zakerl/Capstone_Project/README.md

# The EMAnator - Back End Developers 
<p align="center">
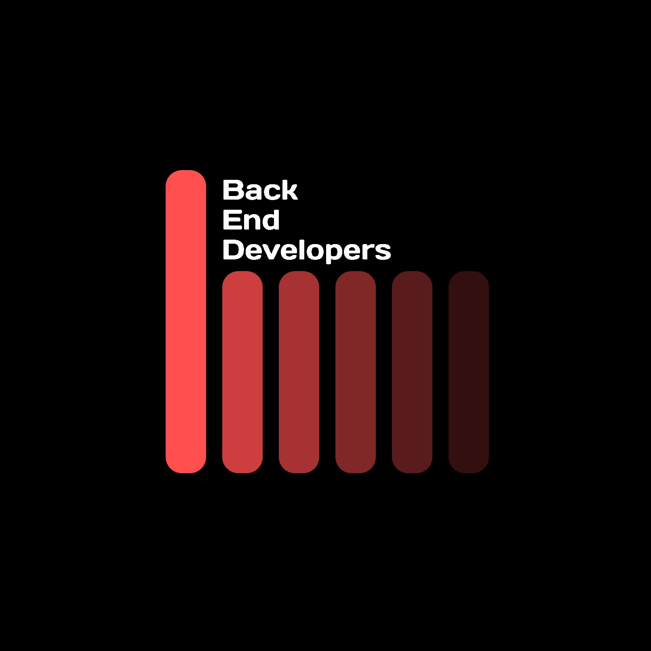
[picture p1: refs/BED_logo.jpg]
  
</p>

The EMAnator (Custom activity tracker) is a device created by the Back End Developers to assist Dr Luciana Macedo https://mira.mcmaster.ca/team/bio/luciana-macedo 
to perform Ecological Momentary Assessment (EMA) research on older adults with lumbar spinal stenosis.

To perform activity tracking, a prototype was engineered to replicate tracking using a sensor box as seen below:

 <p align="center">
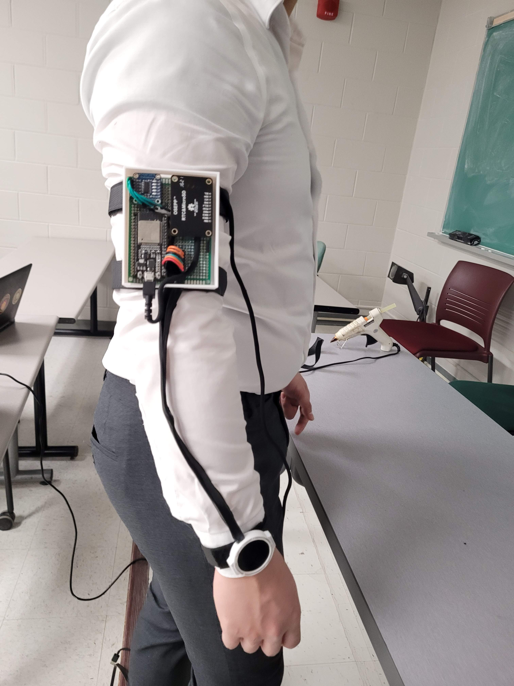
[picture p2: refs/sensorbox.jpg]
  
</p>

To make the device much smaller and like a smart watch that can be worn by participants, a PCB was designed from scratch as seen below:

 <p align="center">
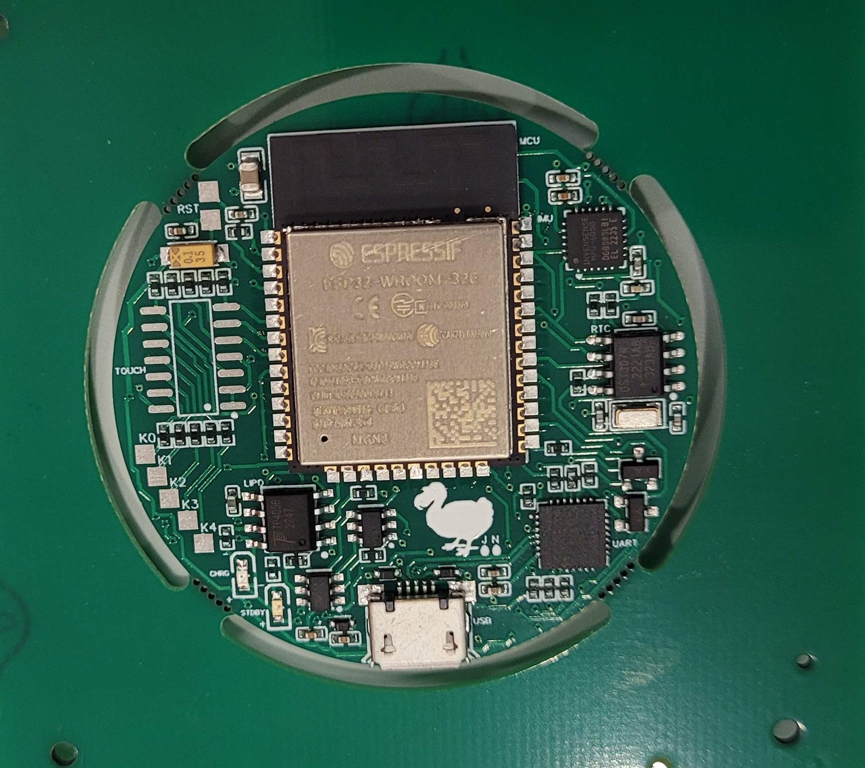
[picture p3: refs/PCB.jpg]
  
</p>

The final functional version of the product is shown below, it has a display and a touch sensor (metal strips) to navigate the display.

 <p align="center">
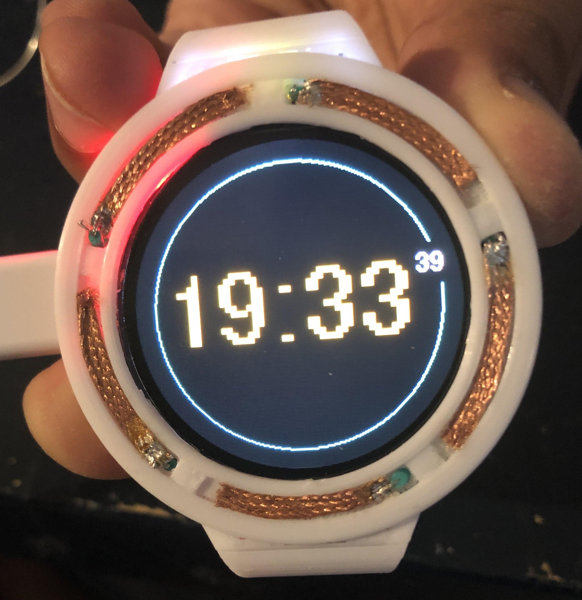
[picture p4: refs/EMAnator.jpg]
  
</p>
