zakerl/Capstone_Project/src/README.md

# EMAnator Source Code

The folders and files for this project (BED - Back End Developers) are as follows:

BED_MAIN_CODE is the source code for the tracker and it has all the files that were used in the development to upload the code and run it on the device.
All the header files are used to define macros and constants that will be used by the main .ino file. 
The different modules are: HR (HeartRate), bluetooth, display, i2c, errors, rtc, sd, touch, prompt, mpu and pin-map.

BED_SD_COM is a test folder for testing bluetooth/serial communication with SD card read/write functionality.
