zakerl/Capstone_Project/refs/README.md

# EMAnator: Reference Information

This folder holds information and resources of interest for the project.  This
is intended to be a convenient location for project members to access
support material for the project.
