zakerl/Capstone_Project/docs/Design/SoftDetailedDes/MIS.pdf

# Module Interface Specification for Mechatronics Engineering


### Team #1, Back End Developers Jessica Bae Oliver Foote Jonathan Hai Anish Rangarajan Nish Shah Labeeb Zaker

### April 6, 2023

### 1 Revision History

Date | Version | Notes
2023-01-18 | 1.0 | Initial documentation
2023-03-15 | 2.0 | Minor improvements and proof reading for revision 1
2023-04-03 | 2.1 | Incorporated TA feedback
2023-04-03 | 2.2 | Included logo and added style to the document

i

### 2 Symbols, Abbreviations and Acronyms

Please refer to the System Requirements Specifications document at this link (https://github.com/zakerl/Capstone_Project/blob/desDoc_Labeeb/docs/SRS/SRS.pdf) for relevant symbols, abbreviations.

ii

### Contents

1 Revision History | i
2 Symbols, Abbreviations and Acronyms | ii
3 Introduction | 1
4 Notation | 1
5 Module Decomposition | 2
6 MIS of Battery Module | 3
7 MIS of microSD Module | 4
8 MIS of Local Database Module | 6

iii

9 MIS of Reading Sensor Module | 9
10 MIS of Sensor Data Processing Module | 11
11 MIS of Display System Module | 13

iv

12 MIS of Prompt Generation Module | 15
13 MIS of Real Time Clock Module | 17
14 MIS of Configuration Module | 19

v

15 MIS of Graph Plotter | 21
16 MIS of Watch Case and Straps Module | 24

vi

### 3 Introduction

The following document details the Module Interface Specifications for the EMAnator; the system currently being developed by the Back End Developers designed to aid in Ecological Momentary Assessment research. This document describes the various relevant details of interfacing with each module. These details include module descriptions, the uses of each module, the syntax of each module, and the semantics associated with each module.

Complementary documents include the System Requirement Specifications and the Module Guide. The Back End Developers highly recommend a thorough read-through of each document prior to a reading of this document to attain the prerequisite knowledge necessary to fully understand this MIS. The System Requirements Specifications can be found at this link, (https://github.com/zakerl/Capstone_Project/blob/main/docs/SRS/SRS.tex) and the Module Guide can be found at this link. (https://github.com/zakerl/Capstone_Project/blob/main/docs/Design/SoftArchitecture/MG.pdf)

### 4 Notation

The structure of the MIS for modules comes from Hoffman and Strooper (1995), with the addition that template modules have been adapted from Ghezzi et al. (2003). The mathematical notation comes from Chapter 3 of Hoffman and Strooper (1995). For instance, the symbol := is used for a multiple assignment statement and conditional rules follow the form (c1 ⇒ r1|c2 ⇒ r2|...|cn ⇒ rn).
The following table summarizes the primitive data types used by Mechatronics Engineering.
Data Type | Notation Description
Character | char | A single symbol or digit
Integer | Z | A number without a fractional compo- nent in (-∞, ∞)
Natural number N | A number without a fractional compo-
| | nent in [1, ∞)
Real | R | Any number in (-∞, ∞)

The specification of Mechatronics Engineering uses some derived data types: sequences, strings, and tuples. Sequences are lists filled with elements of the same data type. Strings are sequences of characters. Tuples contain a list of values, potentially of different types. In addition, Mechatronics Engineering uses functions, which are defined by the data types of their inputs and outputs. Local functions are described by giving their type signature followed by their specification.

### 5 Module Decomposition

The following table is taken directly from the Module Guide document for this project.

Level 1 | Level 2 | Level 3

Hardware-Hiding Module

Battery Management | Battery
Data Storage | microSD Local Database
Sensor Array | Reading Sensor Sensor Data Processing
Physical Design | Watch Case and Straps

Behaviour-Hiding Module

Display System | Display Screen
Prompt Generation | Prompt Generation
Real Time Clock | RTC
Software Decision Module | Parameter Selection | Configuration
| Data Processing | Graph

Table 1: Module Hierarchy

### 6 MIS of Battery Module

### 6.1 Module

Bat Man

### 6.2 Uses

None.

### 6.3 Syntax

### 6.3.1 Exported Constants

- BAT LOW THRESHOLD: Z

### 6.3.2 Exported Access Programs

Name | In | Out | Exceptions
bed get bat level | - | battery level: Z | -

### 6.4 Semantics

### 6.4.1 State Variables

None.

### 6.4.2 Environment Variables

- battery level: Z

### 6.4.3 Assumptions

System responds instantaneously to changes in flags (exported constants).

### 6.4.4 Access Routine Semantics

- bed get bat level: This function returns the battery voltage level as a percentage of the battery’s full charge.

### 6.4.5 Local Functions

None.

### 7 MIS of microSD Module

### 7.1 Module

microSD Stor

### 7.2 Uses

Sensor Prompt Validity Module (Section ??), Real Time Clock Module (Section 13)

### 7.3 Syntax

### 7.3.1 Exported Constants

None.

### 7.3.2 Exported Access Programs

Name | In | Out | Exceptions
listDir | fs: type FS, dirname:
| char *, levels: Z
createDir | fs: | type FS, path:
| char *
removeDir | fs: | type FS, path:
| char *

### 7.4 Semantics

### 7.4.1 State Variables

None.

### 7.4.2 Environment Variables

- fs: type FS

### 7.4.3 Assumptions

- MicroSD card is formatted correctly.
- MicroSD card is inserted correctly.

### 7.4.4 Access Routine Semantics

- listDir: This function lists all files in the path given.
- createDir: This function creates a new folder at the designated path.
- removeDir: This function removes a folder at the designated path.

### 7.4.5 Local Functions

Name | In | Out | Exceptions
readFile | fs: | type FS, path:
| char *

writeFile path: char * , mes- sage: char *
appendFile fs: | type FS, path:
| char * , message: char *

renameFile fs: type FS, path1: char * , path2: char *

deleteFile | fs: | type FS, path:
char *

### 7.4.6 FS Datatype Details

The FS object as defined by the SD.h class.

### 8 MIS of Local Database Module

### 8.1 Module

Database Stor

### 8.2 Uses

microSD Module (Section 7)

### 8.3 Syntax

### 8.3.1 Exported Constants

- MAX CHAR LIMIT: Z
- MAX FIRST NAME SIZE: Z
- MAX LAST NAME SIZE: Z
- MAX GENDER SIZE: Z
- MAX PHONE SIZE: Z
- MAX EMAIL SIZE: Z
- MAX ADDRESS SIZE: Z
- MAX DEVICE MODEL SIZE: Z

### 8.3.2 Exported Access Programs

Name | In | Out | Exceptions
sqlite3.connect | database: type path-
| like
connection: | type
| | Connection | ProgrammingError:
| | | type Exception
conn.cursor | - | cursor: type Cur-
| | sor | ProgrammingError:
| | | type Exception
cursor.execute | sql: char array | - | ProgrammingError:
| | | type Exception
conn.commit | - | - | ProgrammingError:
| | | type Exception
conn.close | - | - | ProgrammingError:
| | | type Exception

### 8.4 Semantics

### 8.4.1 State Variables

None.

### 8.4.2 Environment Variables

- FirstName: char array
- LastName: char array
- Gender: char array
- PhoneNumber: char array
- EmailID: char array
- Address: char array
- MonitoringPeriod: char array
- TrackerModel: char array
- Age: Z
- ParticipantID: Z
- StudyID: Z
- Weight: float
- Height: float

### 8.4.3 Assumptions

None.

### 8.4.4 Access Routine Semantics

- sqlite3.connect: Performs a handshake between the database and the host software
- conn.cursor: Establishes an object through which database transactions occur
- cursor.execute: Executes the SQl statement to the database on the current transaction
- conn.commit: Commits any pending transaction to the database
- conn.close: Closes the database connection

### 8.4.5 Local Functions

None.

### 8.4.6 path-like Datatype Details

The path-like-object is an object which contains the string of the path to the .db database file

### 8.4.7 Connection Datatype Details

An object representing the sqlite3 object.

### 8.4.8 Cursor Datatype Details

An object which contains the functions which manipulate the database

### 8.4.9 ProgrammingError Datatype Details

A subclass of DatabaseError datatype.

### 9 MIS of Reading Sensor Module

### 9.1 Module

Sensor Reading

### 9.2 Uses

Battery Management (Section 6)

### 9.3 Syntax

### 9.3.1 Exported Constants

- ACCEL SENSITIVITY: Z
- GYRO SENSITIVITY: Z
- Threshold: Z
- MPU CALIBRATION: Z

### 9.3.2 Exported Access Programs

Name | In | Out | Exceptions
bed mpu detect | currentTime: Z | - | -
bed hr detect | - | - | -

### 9.4 Semantics

### 9.4.1 State Variables

- currentTime: Z

### 9.4.2 Environment Variables

- curr ax: Z
- curr ay: Z
- curr aZ: Z
- curr gx: Z
- curr gy: Z
- curr gZ: Z

### 9.4.3 Assumptions

- All activity thresholds are provided from the configuration file.

### 9.4.4 Access Routine Semantics

- bed mpu detect: returns the current values of accelerometer and gyroscope.
- bed hr detect: returns the current values of heart rate sensor.

### 9.4.5 Local Functions

Name | In | Out | Exceptions
bed mpu setup | - | b32 err code: Z | b32 err code:
| | | BED ERR MPU
bed hr setup | - | - | -

### 10 MIS of Sensor Data Processing Module

### 10.1 Module

Sensor Data

### 10.2 Uses

Sensor Reading (Section 9)

### 10.3 Syntax

### 10.3.1 Exported Constants

- ACTIVITY STEPS: Z
- ACTIVITY IDLE RESET: Z
- ACTIVITY IDLE WAIT: Z

### 10.3.2 Exported Access Programs

Name | In | Out | Exceptions
bed mpu detect | currentTime:
| Z
bed hr detect | - | - | -

### 10.4 Semantics

### 10.4.1 State Variables

- currentTime: Z

### 10.4.2 Environment Variables

- step count: Z
- TOTAL STEP: Z
- step flag: Z
- activity flag: Z

### 10.4.3 Assumptions

- There is space available in microSD card.

### 10.4.4 Access Routine Semantics

- bed mpu detect: returns the current values of accelerometer and gyroscope
- bed hr detect: returns the current values of heart rate sensor

### 10.4.5 Local Functions

Name | In | Out | Exceptions
bed mpu setup | - | b32 err code: Z | b32 err code:
| | | BED ERR MPU
bed hr setup | - | - | -

### 11 MIS of Display System Module

### 11.1 Module

Disp Sys

### 11.2 Uses

Prompt Generation Module (Section 12), Real Time Clock Module (Section 13), Battery Management (Section 6)

### 11.3 Syntax

### 11.3.1 Exported Constants

- TEXT SIZE: Z
- BED TFT CS: Z
- BED TFT DC: Z
- BED TFT MOSI: Z
- BED TFT SCK: Z

### 11.3.2 Exported Access Programs

Name | In | Out | Exceptions
bed display promptdirection: | Z,
| prompt index: Z, no of options: Z, flag: Z
bed display date time- | - | -

### 11.4 Semantics

### 11.4.1 State Variables

- draw flag: Z
- wait flag: Z

### 11.4.2 Environment Variables

- scroll index: Z
- curr hr: Z
- curr min: Z
- curr sec: Z
- prompt buff: char array
- inPain: char array

### 11.4.3 Assumptions

None.

### 11.4.4 Access Routine Semantics

- bed display prompt: This function takes the type of prompt and prompt index and accordingly generates the corresponding questions and options. Upon answering all the questions, it will save the answers in the SD card.
- bed display date time: This function grabs the current time and draws it to the screen.

### 11.4.5 Local Functions

Name | In | Out | Exceptions
bed init display | - | Response: string | BED ERR DISPLAY SYSTEM:
| | | Z
bed splash screen- | - | -
bed display one linedisplayText:
| char *, coordX: Z, coordY: Z, clearFlag: Z
drawHour | - | - | -
drawMinute | - | - | -
drawSecond | - | - | -

### 12 MIS of Prompt Generation Module

### 12.1 Module

Prompt Gen

### 12.2 Uses

Sensor Array Module (Section 10)

### 12.3 Syntax

### 12.3.1 Exported Constants

- MAX PROMPTS: Z
- WALK PROMPT SIZE: Z
- ALARM PROMPT SIZE: Z
- prompt test: type Prompt (struct)
- prompt walking: type Prompt (struct)
- prompt alarm: type Prompt (struct)

### 12.3.2 Exported Access Programs

None.

### 12.4 Semantics

### 12.4.1 State Variables

None.

### 12.4.2 Environment Variables

None.

### 12.4.3 Assumptions

None.

### 12.4.4 Access Routine Semantics

None.

### 12.4.5 Local Functions

None.

### 12.4.6 Prompt Datatype Details

- Prompt is a struct composed of 5 fields:
- prompt id: Z
- no of options: Z
- prompt question: char array
- prompt possible answers: char array (2D)
- prompt response: char array

### 13 MIS of Real Time Clock Module

### 13.1 Module

RTC

### 13.2 Uses

None.

### 13.3 Syntax

### 13.3.1 Exported Constants

- RTC ADDRESS: Z
- ALARM NUMBER: Z
- alarms: Z array (2D)
- rtc: type RTC DS1307
- now: type DateTime
- daysOfTheWeek: char array (2D)
- monthsOfTheYear: char array (2D)
- rtc date time: type RTC DATE TIME

### 13.3.2 Exported Access Programs

Name | In | Out | Exceptions
bed display info - | - | -
bed alarm promptprev input: Z | new input:
| | Z | -
bed set explicit date timedate: | char *,
| time: char *

### 13.4 Semantics

### 13.4.1 State Variables

- alarm flag: Z
- curr alarm: Z

### 13.4.2 Environment Variables

None.

### 13.4.3 Assumptions

- Initial date and time is correctly set.

### 13.4.4 Access Routine Semantics

- bed display info: This function grabs the current time from the DateTime struct, and stores it in the RTC DATE TIME struct.
- bed alarm prompt: This function checks whether or not an alarm should be triggered based on the time, and accordingly updates the state.
- bed set explicit date time: This function sets the date and time of the RTC explicitly.

### 13.4.5 Local Functions

Name | In | Out | Exceptions
bed init rtc | - | b32 err code:
| | Z | b32 err code: BED ERR RTC SYSTEM

### 13.4.6 RTC DATE TIME Datatype Details

RTC DATE TIME is a struct composed of 6 fields:

- rtc year: Z
- rtc month: Z
- rtc day: Z
- rtc hour: Z
- rtc min: Z
- rtc sec: Z

### 13.4.7 RTC DS1307 Datatype Details

The RTC object as defined by the RTClib system class.

### 13.4.8 DateTime Datatype Details

The DateTime object as defined by the RTClib system class.

### 14 MIS of Configuration Module

### 14.1 Module

Config Param

### 14.2 Uses

MicroSD Module (Section 7)

### 14.3 Syntax

### 14.3.1 Exported Constants

- MAX CHAR LIMIT: Z
- MAX FIRST NAME SIZE: Z
- MAX LAST NAME SIZE: Z
- MAX GENDER SIZE: Z
- MAX PHONE SIZE: Z
- MAX EMAIL SIZE: Z
- MAX ADDRESS SIZE: Z
- MAX DEVICE MODEL SIZE: Z

### 14.3.2 Exported Access Programs

Name | In | Out | Exceptions
object.text | - | enter text: char array | -

### 14.4 Semantics

### 14.4.1 State Variables

- CreateRecord: type QPushButton

### 14.4.2 Environment Variables

- FirstName: char array
- LastName: char array
- Gender: char array
- PhoneNumber: char array
- EmailID: char array
- Address: char array
- MonitoringPeriod: char array
- TrackerModel: char array
- Age: Z
- ParticipantID: Z
- StudyID: Z
- Weight: float
- Height: float

### 14.4.3 Assumptions

- All configuration parameters within acceptable limits.

### 14.4.4 Access Routine Semantics

- object.text: This function grabs what is typed into the UI input box and stores it into a variable

### 14.4.5 Local Functions

None.

### 14.4.6 QPushButton Datatype Details

The object from the PyQt class which enables UI buttons.

### 15 MIS of Graph Plotter

### 15.1 Module

Graph Plot

### 15.2 Uses

Device Manager Module (Section ??)

### 15.3 Syntax

### 15.3.1 Exported Constants

None.

### 15.3.2 Exported Access Programs

Name | In | Out | Exceptions
OpenHeart | - | - | -
OpenSteps | - | - | -
OpenActivity | - | - | -
sqlite3.connect | database: type
| path-like | connection:
| | type Con-
| | nection | ProgrammingError:
| | | type Exception
conn.cursor | - | cursor: type Cur-
| | sor | ProgrammingError:
| | | type Exception
cursor.execute | sql: char array | - | ProgrammingError:
| | | type Exception
conn.commit | - | - | ProgrammingError:
| | | type Exception
conn.close | - | - | ProgrammingError:
| | | type Exception

### 15.4 Semantics

### 15.4.1 State Variables

- HeartGraph: type QPushButton
- StepsGraph: type QPushButton
- ActivityGraph: type QPushButton

### 15.4.2 Environment Variables

None.

### 15.4.3 Assumptions

- Data is in proper format and not corrupted.

### 15.4.4 Access Routine Semantics

- OpenHeart: This function fetches heart rate and time data from the database and plots it on the graph
- OpenSteps: This function fetches step and time data from the database and plots it on the graph
- OpenActivity: This function fetches activity and time data from the database and plots it on the graph
- sqlite3.connect: Performs a handshake between the database and the host software
- conn.cursor: Establishes an object through which database transactions occur
- cursor.execute: Executes the SQl statement to the database on the current transaction
- conn.commit: Commits any pending transaction to the database
- conn.close: Closes the database connection

### 15.4.5 Local Functions

Name | In | Out | Exceptions
Plot | PlotTime: type
Pandas | Data
Frame, | Yaxis:
type | Pandas
Data | Frame,
name: | char
array, | color:
| char array

### 15.4.6 QPushButton Datatype Details

The object from the PyQt class which enables UI buttons.

### 15.4.7 path-like Datatype Details

The path-like-object is an object which contains the string of the path to the .db database file

### 15.4.8 Connection Datatype Details

An object representing the sqlite3 object

### 15.4.9 Cursor Datatype Details

An object which contains the functions which manipulate the database

### 15.4.10 ProgrammingError Datatype Details

A subclass of DatabaseError datatype.

### 16 MIS of Watch Case and Straps Module

### 16.1 Module

Watch Case Strap

### 16.2 Uses

None.

### 16.3 Syntax

### 16.3.1 Exported Constants

None.

### 16.3.2 Exported Access Programs

None.

### 16.4 Semantics

Allow the device to be strapped onto the user.

### 16.4.1 State Variables

None.

### 16.4.2 Environment Variables

None.

### 16.4.3 Assumptions

Will not impact the functionality of any other components.

### 16.4.4 Access Routine Semantics

None.

### 16.4.5 Local Functions

None.

### References

Carlo Ghezzi, Mehdi Jazayeri, and Dino Mandrioli. Fundamentals of Software Engineering. Prentice Hall, Upper Saddle River, NJ, USA, 2nd edition, 2003.

Daniel M. Hoffman and Paul A. Strooper. Software Design, Automated Testing, and Maintenance: A Practical Approach. International Thomson Computer Press, New York, NY, USA, 1995. URL http://citeseer.ist.psu.edu/428727.html.
