zakerl/Capstone_Project/docs/SRS/SRS.pdf

# Software Requirements Specification for Mechatronics Engineering: An EMA Enabled Activity Tracker and Prompting System


### Team #1, Back End Developers Jessica Bae Oliver Foote Jonathan Hai Anish Rangarajan Nish Shah Labeeb Zaker

### April 5, 2023

i

### Contents

1 Reference Material | v
2 Introduction | 2
3 Users and Stakeholders | 5
4 General System Description | 5
5 Specific System Description | 8
6 Required Behavior | 12

ii

7 Requirements | 13
7.1 Functional Requirements | | 13
7.2 Likely/Unlikely Changes for Functional Requirements | | 14
7.3 Nonfunctional Requirements | | 14
8 Traceability Matrices and Graphs | 20
9 Development Plan | 21
10 Values of Auxiliary Constants | 21
11 Project Attributes | 22
12 Normal Operation Overview | 23
13 Undersired Event Handling | 24
14 FSM and Dataflow Diagram | 25
15 Legal and Regulatory Factors | 27
16 Phase in Plan | 27

### List of Figures

1 | System Context | | 6
2 | FSM | | 25

### List of Tables

1 | Revision History | | iv
2 | Table of Basic Units | | v
3 | Table of Derived Units | | vi
4 | Table of Symbols | | vi
5 | Table of Constants | | vi
6 | Table of Abbreviations and Acronyms | | 1
7 | Table of Monitored Variables | | 9
8 | Table of Controlled Variables | | 9
9 | Table of Likely and Unlikely Changes | | 14
10 | Traceability Matrix Showing the Connections between Assumptions and Other Items 20
11 | Traceability Matrix Showing the Connections Functional Requirements and Non-
| Functional Requirements | | 21
12 | Bill of Materials | | 22

iii

### Revision History

Date | Version | Notes
2022-10-05 | 1.0 | Initial Revision
2022-11-01 | 1.1 | Added extra sections,new requriements and hyperlink-
| | ing
2022-11-05 | 1.2 | Additional non-functional requirements added pertain-
| | ing to hazard analysis
2022-04-02 | 2.0 | Incorporated TA comments for rev1
2022-04-04 | 2.1 | Proofread
2022-04-04 | 2.2 | Added logo and style to the document

Table 1: Revision History

iv

### 1 Reference Material

This section records information for easy reference.

### 1.1 Table of Units

Throughout this document SI (Syst`eme International d’Unit´es) is employed as the unit system. In addition to the basic units, several derived units are used as described below. For each unit, the symbol is given followed by a description of the unit and the SI name.

Table 2: Table of Basic Units

symbol unit | SI
m | length | metre
kg | mass | kilogram
s | time | second
- | angle | degree
rad | angle | radian
V | potential | volts
A | current | ampere
Ω | resistance | ohm (Ω= V A⁻¹
)
F | capacitance farad
H | inductance | henry
N | force | newton (N = kg m s⁻²
)
Pa | pressure | pascals (Pa = Nm⁻²
)
Hz | frequency | hertz
J | energy | joule
W | power | watt (W = J s⁻¹
)

v

Below are some derived units that do not use a specific SI symbol.

Table 3: Table of Derived Units

Derived unit SI

area | m²
volume | m³
velocity | m s⁻¹
acceleration | m s⁻²

### 1.2 Table of Symbols

The table that follows summarizes the symbols used in this document along with their units. The choice of symbols was made to be consistent with kinematics and existing documentation of existing activity trackers. The symbols are listed in alphabetical order.

Table 4: Table of Symbols

symbol unit | description
fc | Hz | clock frequency of microcontroller
mtracker | g | mass of activity tracker (device)
ar | m s⁻² | accelerometer resolution
Atracker | m² | estimated area of activity tracker
Vbattery | V | supplied voltage of battery

### 1.3 Constants

Below are the constant that will be used in the device.

Table 5: Table of Constants

symbol value and unit | description
g | 9.81 m s⁻²
acceleration due to gravity fESP32 Adjustable from 80 MHz to 240 MHz clock frequency of ESP32-D0WD chip.

vi

### 1.4 Abbreviations and Acronyms

Table 6: Table of Abbreviations and Acronyms

symbol description

A | Assumption
ACC | Acceleration
BAR | Barometer
CSV | Comma-Separated Values
CV | Controlled Variables
DD | Data Definition
EMA | Ecological Momentary Assessment
FSM | Finite State Machine
GD | General Definition
GS | Goal Statement
GYR | Gyrometer
IM | Instance Model
LC | Likely Change
LSS | Lumbar Spinal Stenosis
MV | Monitored Variables
NFR | Non-Functional Requirements
OOP | Object Oriented Programming
PID | Proportional-integral-derivative
PS | Physical System Description
R | Requirement
SI | Syst`eme International d’Unit´es
SReS | School of Rehabilitation Sciences
SRS | Software Requirements Specification

### 1.5 Mathematical Notation

N/A

1

### 2 Introduction

Researchers at the School of Rehabilitation Sciences (SReS) at McMaster University are investigating treatment strategies for people with spinal disorders and back pain. Currently, there is great interest in performing Ecological Momentary Assessment (EMA) on those who suffer from back pain and disorders to make treatment options more effective. EMA aims to study the thoughts, experiences, and behaviours of a patient’s daily life by repeatedly collecting data in an individual’s normal environment, at or close to the time they carry out that behaviour.

Specifically, the type of EMA that the SReS is interested in is focused on analyzing the daily activities and symptoms of mostly-older adults with mobility and spinal issues. For example, they may be interested in performing EMA on a patient with spinal compression issues which prevent them from being able to walk long distances without experiencing pain or distress. They wish to track that patient’s walking activity as they go about their daily life. If this patient stops walking or moving, they wish to prompt them with questions such as, ”Did you stop moving? If so, was it due to pain? Describe your pain, describe which portion of the body it is in.” The answers to these questions will be combined with activity monitoring data to form a better picture about the experience this patient has with their spinal and mobility issues.

EMA has become an increasingly popular research methodology in the realm of pain related studies. In 2022, the SReS wished to evaluate the feasability of an eHealth-based prehabilitation program for participants undergoing surgery for lumbar spinal stenosis (LSS). Bakaa et al. (2022) This study incorporated EMA into the study; With a wearable triaxial accelerometer (Actiwatch Spectrum Pro Startup, Philips, USA) worn for seven days in a row, total weekly minutes of physical activity were recorded. This battery-operated accelerometer captured time-varying accelerations. Data was gathered on maximum duration of continuous exercise, volume of activity (total counts of activities per week), energy expenditure intensities, and maximal intensity (maximum counts of activities per minute). Then for three times a day for seven days, participants were asked to assess how severe their pain and exhaustion were. This data was collated together and used to evaluate the evaluate the effect LSS had on walking ability and daily pain.

In order to accomplish this, the researchers have attempted to use various smart-watch-esque activity tracking devices to track the activity of their patients, and have attempted to use apps and different pieces of software for them to prompt their patients with questions. However, they have been frustrated with very limited success, and are looking for a system which integrated precise and relevant activity tracking with user-friendly self-reporting symptom functionality.

The researchers require a method to perform EMA analysis in a manner which even older patients can use, integrated into one package which gathers relevant data about a patient’s activities and allows them to easily report what is currently going on and how they feel. They also are looking for a way to access EMA data in various ways. This includes graphical representations of the data which are meaningful to researchers, along with the raw data itself. This data could

2

be activity data, symptoms reporting data, both types of data collated together, and so on.

This introductory section of the document is intended to provide a reader with an overview of the purpose, overall scope, and organization of the document. As well as a description of the characteristics of the intended reader of this document.

### 2.1 Purpose of Document

This document is intended to describe the requirements of Team #1’s system in a structured and collected manner. In other words, this is a document focused on what the system needs to do and the metrics and methods used to measure its performance. This groundwork is laid in a way to allow every individual who reads this document to understand the details essential to the requirements of this system.

Additional purposes of this document are to plan for the design stage of the project, foster effective communication between members of the team, and to establish reference material to which team members will be able to refer back to at later stages in the project should they need to acquire a higher-level view of the system.

### 2.2 Changes from template

This document was written based off of the sample work provided in the 4T06 course gitlab page, and changes have been made from the template accordingly. They are included here:

Added a constants subheading to section 1. This project does not use the mathematical notation included in the template.

Added a section for users and stakeholders.

Added subsections for monitored and controlled variables.

Renamed Solution Characteristics Specifications to Assumptions, as most of the original Solution Characteristics Specifications is not relevant to this project, other than the assumptions section.

Sections 5.2.1 through 5.2.7 are not applicable to this project and have been labelled N/A.

The Development Plan and Value of Auxiliary Constants sections are not applicable to this project and have been labelled N/A.

Added a section for Project Attributes, Normal Operation Overview, Undesirabled Event Handling, and FSM and Dataflow Diagram, and Legal and Regulatory Factors.

3

### 2.3 Scope of Requirements

The scope requirements for a system which satisfies the goals of EMA must be defined properly. In the case of this project, the requirements must include a method of activity monitoring and a way to prompt users with questions relevant to EMA. In addition, this system will be used by older adults in Canada, specifically in a typical Canadian household environment, likely with a fixed daily routine. This system is not intended to be used by bedridden or sedentary users. If a user is unable to maintain a certain level of movement on a regular basis, the entire point of EMA is rendered moot. It is also necessary to exclude children from the sphere of users. This system must be designed for adults, aimed specifically towards older adults.

### 2.4 Characteristics of Intended Reader

While this document is intended to describe the requirements of the system in as abstract of a method as possible, it is unreasonable to expect a layman without any knowledge within the field of mechatronics to understand the contents of this document. Therefore, there are certain characteristics that a reader must have in order to fully grasp the scope of this SRS.

A reader should have a grasp of software development, electronics, mechanics and dynamics at a level equivalent to a 3rd-Year Mechatronics Undergraduate University student, as well as a basic understanding of human anatomy of which a high school level is adequate.

In addition, a reader should have a high-level understanding of Ecological Momentary Assessment. This does not have to be particularly in depth, but a reader should be able to identify the main objectives, practices, and difficulties of performing EMA.

### 2.5 Organization of Document

This document is organized in a way to make it simple for a reader to understand the essentials regarding the requirements of the system. Should one be interested in gaining a general understanding, it is highly recommended to read this document in its entirety. However, should one wish to learn about specific aspects of this project, please feel free to navigate to any individual section as they are each individually comprehensible. If the reader of this document is a participant in the SReS EMA program, the information relevant is located in sections 2, 3, and 4. If the reader of this document is a researcher performing EMA, the information relevant is located in sections 3, 4, 5, 11, 12, and 13.

4

### 3 Users and Stakeholders

Stakeholders

– Dr. Luciana Macedo of School of Rehabilitation Science at McMaster University (Primary Project Supervisor).

– Dr. Spencer Smith (Project Supervisor).

Stakeholders that are Users: The design has 2 different stakeholders which will be users of the system:

– Researchers: Primary end user who will use the data collected by the device for analysis and research.

– Patients/Participants : Users part of the monitoring study who will be wearing the device, and whose activities will be collected for research and analysis.

### 4 General System Description

This section provides general information about the system. It identifies the interfaces between the system and its environment, describes the user characteristi cs and lists the system constraints.

### 4.1 System Context

This system in theory is very simple. An array of sensors grabs info regarding the position, speed, orientation, etc. and uses that information to understand the current state of the user. This data is then used to generate prompts that the user will answer and all the collected data is compiled, processed and stored within the system. Finally, researchers will analyze the collected data and generate observations.

5


Figure 1: System Context

Patient Responsibilities:

– Patients are required to set up the device correctly so that their various attributes (Orientation, velocity, etc.) can be collected.

– Patients are also required to answer the prompts given to them so that adequate data can be collected.

Researcher Responsibilities:

– Required to confirm that data is being collected.

– Required to set up the intial thresholds and activities for tracking.

– Analyze the data.

– Charge and calibrate the system.

6

### 4.2 User Characteristics

Patients should have a general understanding of using smart devices with touch-bezel interfaces. Patients will also be required to wear the device on their body so a good understanding of how to setup the device and secure it will be required. Finally the device will prompt users to answer certain prompts, thus knowledge of what to expect and how to respond is required.

Researchers will have the option of tweaking the configuration of the device, allowing them to manipulate certain activity thresholds. Thus a working knowledge of the system is required. Moreover, a basic understanding of graphs and statistical analysis will be required to understand the research data collected by the device.

### 4.3 System Constraints

The design will consist of both a hardware and a software system. The constraints for both systems are as follows:

Hardware:

HC1: The system must weigh less than 100g to facilitate being lightweight and comfortable.

HC2: The system must have an average battery life of at least 24 hours to facilitate monitoring of the users.
HC3: The dimensions of the system must be quite small with an area lower than 2500mm² .

Software :

SC1: The system will have hard time constrainsts so as to store data and prompt users with low latency .

SC2: To maintain privacy, the system will only store data for as long as the EMA study period lasts.

SC3: The system must prompt users based on activities and not based on time of day.

7

### 5 Specific System Description

### 5.1 Problem Description

Dr. Luciana Macedo investigates treatment strategies for older adults with musculo-skeletal disorders, based on the results reported through Ecological Momentary Assessment (EMA). The current solution is not very sensitive to slow and subtle movements. It also works on a time-based approach, reporting data after specified intervals. Moreover, the Human Computer Interface is not user-friendly for the targeted audience and the data gathered is difficult to analyze. The motive is to design a device that is able to capture very minor movements, that could produce data of interest based on the survey results along with a well-designed interface following HCI conventions allowing users to navigate with ease.

### 5.1.1 Terminology and Definitions

This subsection provides a list of terms that are used in the subsequent sections and their meaning, with the purpose of reducing ambiguity and making it easier to correctly understand the requirements:

PID controller: This stands for proportional–integral–derivative controller. It is an instrument used in industrial control applications to regulate temperature, flow, pressure, speed and other process variables.

FSM: This stands for Finite State Machine. An FSM is a machine that can be in a specific state from finite set of states based on previous conditions and inputs.

TFT LCD: It stands for Thin-Film-Transistor Liquid Crystal Display. This is the display screen where data is shown.

MVC: Model-View-Controller. It is a software architectural pattern used to implement user interfaces, data and controlling logic. It separates display from program logic.

Control variables: These are the variables that will be controlled in our implementation and research to avoid their impact.

Monitored variables: These are the variables that will be calculated based on program logic and output as a result.

8

### 5.1.2 Monitored variables

Monitored Variable | Description | Units
m batteryLife | This signal is used to monitor the battery life. | Integer(%)
m modeUser | This signal is used to indicate who is the user. There are only two types of users: participant and researcher. Mode for participant is 0 and 1 for researcher. | Boolean
m ActivityDetected | This signal is used to monitor the current state of the par-ticipant. | struct(Boolean, Integer)
m promptAnswered | This signal is used to monitor the state of the participant response to the activity prompt. | Boolean
m monitorPer | This signal is used to monitor the duration, the participant has been monitored since the device has been turned on. | Integer (num-ber of days)
m valConnect | This signal is used to indicate whether the researcher’s system can be validated as a host. | Boolean
m senCalVal | This signal is used to indicate whether the sensors have been calibrated successfully according to the researcher’s con-straints. | Boolean

Table 7: Table of Monitored Variables

### 5.1.3 Controlled variables

Controlled Variable | Description | Units
c batteryLife | This is the battery threshold that the battery life should be above to indicate that the device is good for usage | Integer(%)
c monitorPer | This is the monitoring period set for participants by the re-searcher. The device shall be collecting data within this pe-riod. | Integer (number of days)
c modeResearcher | This flag is used to control what the software does. There are 3 different actions: for Calibration, Accessing patient records, and Accessing data collected. | Integer

Table 8: Table of Controlled Variables

9

### 5.1.4 Comparison to existing solutions

Most of the solutions are just softwares when installed, uses phone sensor data to cause an intervention. They are very dependent on mobile phone sensors, meaning if there are no sensors on the phone, the software application becomes obsolete. The app might also have to be open 24/7 or running in background to be able to read live sensor data. Some of the current solutions involved a time-based EMA trigger which may cause the data collected to be segregated as the trigger time intervals could be well beyond when the user expressed a desired behaviour.

Most of the solutions could include smartwatches such as Fitbit, Samsung Galaxy Watch. These products are not very accurate as they could track movement wrongly, leading to wrong results. These devices can also be easily tampered by participants, which could affect the results produced in favour of participants. They also tend to be very expensive due to some features offered, which may not be useful to the situation.

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

### 5.1.5 Physical System Description

PS1: The display screen will be around 2500 mm²
. This will be the interface between the user and the system.

PS2: The bracket around the screen will be approximately 2700 mm²
. This will be an added
layer of protection against the screen to avoid damages to the screen itself.

PS3: The weight of the device will be less than or equal to 100 grams. This is because of the additional weight coming from the straps and embedded sensors. The resultant force will be in the direction of arm, since arm weighs approximately 3.5 kg, making the device lightweight.

PS4: The strap will be approximately 75mm long on the short side and 140 mm long on the long side, so that it sits perfectly and comfortably on the user’s wrist.

10

### 5.1.6 Goal Statements

GS1: Minor movement tracking: The idea is to be able to capture very subtle, minor movements, as most activity trackers are incapable of doing it. Since our target audience have limited movements, the device needs to be sensitive to capturing minor motion since that would produce the desired data.

GS2: Event-based prompting: Based on desired trigger events, the user would be prompted to complete the EMA.

GS3: Simple User Interface: We want to be able to design a very intuitive User interface, one that would be very interactive and easy to navigate around. This would result in quicker and more accurate survey submissions as they are prompted.

GS4: Graph Representation: Researchers desire to be able to capture the trends in the behaviours over a set time. Graphical outputs are the best method to capture and understand the behaviour of certain dependent variables.

### 5.2 Assumptions

A1: All users are fluent English speakers.

A2: The device is to be used under normal daily activities.

A3: All patients are to receive verbal instructions from their researcher on how to use their devices.

### 5.2.1 Theoretical Models

N/A

### 5.2.2 General Definitions

N/A

Detailed derivation of simplified rate of change of temperature

N/A

### 5.2.3 Data Definitions

N/A

### 5.2.4 Data Types

N/A

11

### 5.2.5 Instance Models

N/A

Derivation of ...

N/A

### 5.2.6 Input Data Constraints

N/A

### 5.2.7 Properties of a Correct Solution

N/A

### 6 Required Behavior

The activity tracking system should have the following required behavior:

Motion tracking should be accurate and in line with industry standards in activity tracking

The activity tracker must be able to turn on, or reboot itself without user intervention if an issue is detected

The battery must last a minimum of 24 hours

The system must be able to store at least one EMA period’s worth of activity tracking data locally

The system should be intuitive and seamless for the user

12

### 7 Requirements

This section provides the functional requirements, the business tasks that the software is expected to complete, and the nonfunctional requirements, the qualities that the software is expected to exhibit.

### 7.1 Functional Requirements

Below are the functional requirements of the device as well as the rationale.

R1 | Device stays on during the monitoring period.
Rationale | The User/Researcher would want to turn on/off the device when not in use.
R2 (Prority) | Device has to track minor movements of user such that activity is recorded appro-priately.
Rationale | The device will have to track minor movements as a lot of the participants have limited mobility.
R3 (Prority) | Device has to notify the user when the software detects a registered activity relavent to EMA standards and that is signficant or promptable.
Rationale | The device will have to prompt the user if activity stops to check if they are in pain.
R4 | The activity tracker/system should be such that the user can attach/wear it on their body.
Rationale | The system will be attached to an individual’s wrist in order to detect activity.
R5 | Input thresholds should be customizable in the software of the device in a simplistic manner.
Rationale | The Researcher should be able to change input thresholds in order to tweak the device’s settings.
R6 (Priority) | The device will store all relavent data every time an activity takes place or a prompt is answered on the device.
Rationale | The data will have to be stored in the on-board memory of the device so that the researcher can extract it.
R7 (Prority) | The data stored on the device will be able to be extracted such that the data is interpretable in the form of graphical representation and raw data.
Rationale | The researches require data in formats conducive to conducting clinical EMA stud-ies. These formats are most commonly spreadsheet or graphical forms.

13

### 7.2 Likely/Unlikely Changes for Functional Requirements

Requirement | Likelihood of Change | Rationale | Ways to Change
R1 | Very Unlikely | Key Implementation | N/A
R2 | Likely | Degree of tracking | Change tracking reesolution.
R3 | Very Unlikely | Key Implementation | N/A
R4 | Unlikely | Key Implementation | N/A
R5 | Unlikely | Key Implementation | N/A
R6 | Very Unlikely | Key Implementation | N/A
R7 | Unlikely | Ensures data reaches Researcher | Method of data storage can be changed.

Table 9: Table of Likely and Unlikely Changes

### 7.3 Nonfunctional Requirements

NFR1 : Accuracy: The accuracy of the data collected during each EMA session by this device must meet the level needed for academic research based on said results. This includes results from sensors capturing participant activity, answers provided by participants from event prompting, timestamps of data inputs, geolocation information, and any other information pertinent to the form of EMA being performed.

Rationale: Should the EMA data coming from the system be considered inaccurate or incomplete, this system is effectively rendered moot as it is intended to be used in a research setting.

Fit Criterion: The data recorded, stored, and submitted by the system should be accurate to a level considered satisfactory to standard EMA studies conducted by the SReS.

14

NFR2 : Usability: This system should useable by any individual participant who falls within the categeries defined within the user characteristics section of this document. In addition, this system should be easy to set up, monitor, maintain, and reconfigure by any researcher performing EMA using the device.

Rationale: As many of the participants may be older adults, they may be unfamiliar with modern activity tracking technology. It is unreasoneable to expect such participants to be able to use the functions of this system unless it is explicitly designed to be useable at any level of experience with technology. Also, we don’t wanna waste the time of the researchers or introduce unneccessary complexity into operating this system which may introduce erroneous inputs or data interpretations based on confusing interfaces.

Fit Criterion: The system’s interfaces (both to the researchers and the participants) should fit the guidelines of HCI standards, with an emphasis on making this system more useable for those unfamiliar with modern technology.

NFR3 : Maintainability: Once completed, the system should be entirely maintenance free for the time period it is used for EMA (7 to 14 days). The participants should not have perform any maintenance actions other than charging the device. during this period, and the researchers at most should have to recharge the batteries of the system again and update the parameters they set for the next set of EMA.

Rationale: As many of the participants may be older adults, maintenance of this system may be daunting to those unfamilar with modern technology. In addition, any downtime due to maintenance needs during each EMA period will result in a loss of valuable EMA data.

Fit Criterion: Once activated, the system should perform all of its functions continuously without error for a period of 7 days.

15

NFR4 : Portability: The system must be capable of performing its functions of data collection and prompting in any location or situation a participant may find themselves in (within their daily activities). In addition, the system must be constructed in a manner which allows the participant to wear/carry, move, and use the device easily and without hassle.

Rationale: Ecological Momentary Assessment (EMA) is meant to be performed at almost all points of a participant’s daily routine. If the system is bulky, difficult to maneuver around or wear, or heavy, a participant’s movement and actions will be hindered and they will be unable to provide EMA data accurately.

Fit Criterion: Has been tested in each individual environment where EMA will be taking place with satisfactory results regarding its portability.

NFR5 : Cleanability: Each portion of this device must be capable of being cleaned, sanitized, and made hygenic before and after each period of EMA which it is used for. As each component of the device is constructed and used in a different manner, the different needs each component has in order to render it clean must be considered as well.

Rationale: In a post-COVID world, maintaining personal hygiene is rightfully considered an important aspect of daily life. It is the responsibility of this devices makers to ensure conditions or practices conducive to maintaining health and preventing disease, especially through cleanliness.

Fit Criterion: Can be sterilized, cleaned, or treated safely and in a manner satisfactory to the standards of the participants and researchers of the SReS.

NFR6 : Safety: The system must be designed in a way which prevents any harm or injury (whether it be physical, emotional, or mental) from coming to the participants as a result of the useage of the device and its information collection methods. This includes physical characteristics which prevent immediate injury (removal of sharp objects, useage of soft materials), physical characteristics which prevent long-term adverse health effects (human-safe materials, safe levels of noise production), or any other considerations that need to be taken in order to prevent harm to the participant.

Rationale: Safety speaks for itself. To put a participant in harms way as a result of the functions of this system would be a gross violation of ethics.

Fit Criterion: The system conforms to the health and safety standards deemed appropriate by the SReS.

16

NFR7 : Reusability: The system must be capable of being reused for an appropriate number of times. This means that the system must be capable of completing its functions without error after each period of EMA without need for significant upkeep other than regular maintenance (cleaning the device, scrubbing data from the system, etc.)

Rationale: Researchers at the SReS intend to use this system for a vast number of EMA periods, and for multiple different forms of research which EMA may assist with. This system must be designed to be able to sustain its functions for whatever purposes and periods of time which the researchers need.

Fit Criterion: Can be used for 3 consecutive EMA study periods without need for significant maintenance other than nightly charging.

NFR8 : Privacy: This system must protect the data collected from the participants from being accessed or distributed to inappropriate entities or people.

Rationale: Data privacy is a right, and one that must be taken seriously. When revealed to inappropriate people or entities, personal information can be used to negatively affect a participant to a great extent. Preservation of the security of participant’s peronal information is therefore essential.

Fit Criterion: Data is collected, distributed, and then erased from the system according to modern data privacy standards.

NFR9 : Accessibility: This device must be accessible to any participant who is partaking in EMA. Regardless of disability, mental or physical status, a participant must be capable of utilizing this device for EMA with the full ability to collect and respond to prompts in accordance with EMA principles. This includes designing the system’s phyical portion with accessibility needs in mind, along with designing the system’s software, user interface, and data collection portions to allow any participant to be able to use it.

Rationale: If this device is exclusionary to those with special accessibility needs, then it is severly limited in its use for EMA. According to the user characteristics, this device will mostly be used for those suffering from musculo-skeletal disorders, and many of these participants may be suffering from additional disabilities as well.

Fit Criterion: The system has been verified to perform in accordance to modern accessibility standards, for both the physical component of the system, and the data collection/software component of the system.

17

NFR10 : Non-Disruptiveness: The system must be designed in a way which allows participants to provide EMA data without significant impact or change to their activities or daily life. This includes bulky constructions which they must spend effort in considering while moving around, significant visual or auditory disruptions which may startle, distract, or annoy participants, embarassing or aesthetically unpleasant constructs, or any other disturbances that they must make considerations for.

Rationale: It is of paramount importance that this device does not disrupt the daily activities of participants in order to preserve their dignity, and allow them to perform the necessary tasks of their daily lives. In addition, the less the system disrupts their daily activities, the more accurate the picture will be that the system captures of what those daily acitivities are and their relevance to EMA.

Fit Criterion: The system must be rated sufficiently non-disruptive to the daily lives of the participants using the system during testing.

NFR11 : Hardware Safety: To ensure hardware safety, is it important that the device have sufficent tollerances for current, and voltage. Battery protection units will be used in the circuitry, and the battery will have charge protection to prevent overcharging/discharging. Additionally, the intensity of frequencies will be in line with safe levels.

Rationale: Saftey is a top priority. Causing no harm to society is an important part of an engineers code of ethics. Ensuring that the device can be used safely will inherintly make participants feel safe about the use of the device.

Fit Criterion: The hardware systems must be designed to ensure that participants are not harmed under normal usage of the device.

NFR12 : Messaging: The system should be able to deliver messages to the participant on the state of the device. These messages can be in the form of prompts or visual signals using LED indicator lights. They should be intuitive to understand and help particpants solve problems on their own without the assistance of the engineering team or the researchers.

Rationale: Straightforward messaging can help the partipants better navigate using the device, or may be able to tell them if the device is having an issue.

Fit Criterion: Message shouldn’t be necessary under normal operation, but if the system does malfunction, have associated indications to help diagnose these problems is an important step in making the device user friendly.

18

NFR13 : Hardware Performance: Ensuring that the hardware of the device is performing up to expected requirements is important. Some of these performance metrics include the speed of data transfer and the battery life of the device. Specifications have been discussed with researchers by comparing devices like FitBits or Garmin watches with respect to performance and battery life.

Rationale: Perfomance is not just important as a goal for usability, but it is important to ensure that the data which is being collected can be collected in real-time so that the data is accurate and properly displays to the researchers the information they are trying to gather.

Fit Criterion: The battery should last beyond the recommended timelines which will be testing during volunteer tests and the data should have a transfer speed that allows for real-time information to be collected and aggregated.

NFR14 : Data Security: The system must ensure that security of participants data is paramount. Since the device will be handling health records it is important that the device keep the data secured. The data should be well protected so that someone with a high capability in techonlogy would not be able to access the data without a security key.

Rationale: Health records can be used for malicious reasons, and privacy in general is very important to the particpants.

Fit Criterion: The data should not be accessible by anyone without a physical security key.

19

### 8 Traceability Matrices and Graphs

The purpose of the traceability matrices is to provide easy references on what has to be additionally modified if a certain component is changed. Every time a component is changed, the items in the column of that component that are marked with an “X” may have to be modified as well. In other words it shows the dependencies between different requriements and assumptions in the document.

Table 10: Traceability Matrix Showing the Connections between Assumptions and Other Items

| A1 | A2 | A3
R7.1 | | | X
R7.1 | | X
R7.1 | X | X | X
R7.1 | | X | X
R7.1
R7.1
R7.1 | X
NFR7.3 | | X
NFR7.3 | X | X | X
NFR7.3
NFR7.3 | | X
NFR7.3 | X
NFR7.3 | | X | X
NFR7.3 | | X
NFR7.3 | X | | X
NFR7.3 | X | | X
NFR7.3 | | X

20

Table 11: Traceability Matrix Showing the Connections Functional Requirements and Non-Functional Requirements

| R7.1 | R7.1 | R7.1 | R7.1 | R7.1 | R7.1 | R7.1
NFR7.3 | | X | X | | | | X
NFR7.3 | X | | X | X | X | | X
NFR7.3 | X | | | | | X
NFR7.3 | | X | | X
NFR7.3 | | | | X
NFR7.3 | X | X | | X
NFR7.3 | | | | X | | | X
NFR7.3 | | X | | | | X | X
NFR7.3 | X
NFR7.3 | X | | X | X | X

The purpose of the traceability graphs is also to provide easy references on what has to be additionally modified if a certain component is changed. The arrows in the graphs represent dependencies. The component at the tail of an arrow is depended on by the component at the head of that arrow. Therefore, if a component is changed, the components that it points to should also be changed.

### 9 Development Plan

The development plan is available at this link. (https://github.com/zakerl/Capstone_Project/blob/main/docs/DevelopmentPlan/DevelopmentPlan.pdf)

### 10 Values of Auxiliary Constants

N/A

21

### 11 Project Attributes

This is a comphrehensive list of the various Open Issues, Costs and Risks involved with the project. This will be updated to reflect changes in the Design. Moreover this section also includes some stretch goals that may be accomplised depending on the pace and scale of the project.

Open Issues:

– A decision must be made whether the design will be worn on the wrist like a smart watch or on the waist like a belt.

– Sensor choices must be decided for optimal state detection of the user.

– Data transfer protocol must be decided, (Bluetooth, Ethernet, Wifi etc.)

– Cost analysis must be performed to see whether designing a custom PCB would be economical.

Costs:

Table 12: Bill of Materials

SNo. | Item. | Cost ($CAD)
1 | ESP32-WROOM | $17.72
2 | MPU6050 (Accelerometer/ Gyroscope) | $12/unit
3 | PCB Manufacturing Service including shipping (JCL) | $87.73/board
4 | XD-58C (Heart Rate Sensor) | $3
5 | microSD reader | $15/unit
7 | Lipo Battery | $30
8 | Display Screen | $15
9 | Structural Materials (3D printing, watch strap, etc.) | $10
| Average Total Cost | $190.45

22

Risks:

– Battery life will degrade over time.

– Device is not sanitized between different monitoring periods.

– Device is improperly calibrated causing improper data collection.

– User error when answering prompts.

– Internal memory storage may become full if redundant data isnt regularly removed.

Stretch goals: Detailed explanations of the following are provided in the Specification/Problem Statement Document.

– Detection of Anomalous behaviour may be added to track irregular movements.

– Geotagging location of the activities being tracked to achieve observations about high traffic activity areas.

– To optimize charging the device, a movement based charging system may be implemented.

### 12 Normal Operation Overview

Initially, the researcher will connect to the device using the provided software and either register a new participant or select a pre existing participant profile. Once a participant is selected, the researcher can set the thresholds, activities to be tracked and the monitoring period.

Once the device is handed off to the participant, an inital set up process is done, where the device is worn by the user and a test prompt is sent. Once this initial set up process is done, the user will simply carry on with their normal day to day and the device will track all registered activities using the onboard sensors. As the data is collected, it is logged into the internal memory and is stored based on the date and time of entry. The user will then remove the device nightly after their daily routine, and charge it for the next day’s use.

Finally after the monitoring period is finished, the device will go into an idle state until it is returned to the researcher. The researcher will then log in using their master credentials at which point the device will off load all data into the host software which will compile and present the data in a graphical manner.

23

### 13 Undersired Event Handling

Incorrect start up prompt response: When the device is turned on by the user for the first time. A simple start up prompt is given just to check that system booted correctly (”Is this device on?”). If the user incorrectly enters their responsem, the system will simply perform a quick restart and ask the same question again.

Stagnant sensor data: Should the device store the same sequence of data for an extended period of time, the system will perform a soft reboot of the sensor array to try to fix the issue. If the problem persists, An alert will be sent out to the researchers informing them of a system failure.

Improper prompt request: Should the device generate a prompt whe no activity is being conducted. The user can simply report the prompt and the sytem will record an error, perform a soft reboot and continue normal operation.

Early battery failure: The device’s battery should normally last 24 hours. If the charge goes below a predefined threshold before the monitoring period ends, activity tracking will cease and the user will be prompted to charge the device.

24

### 14 FSM and Dataflow Diagram

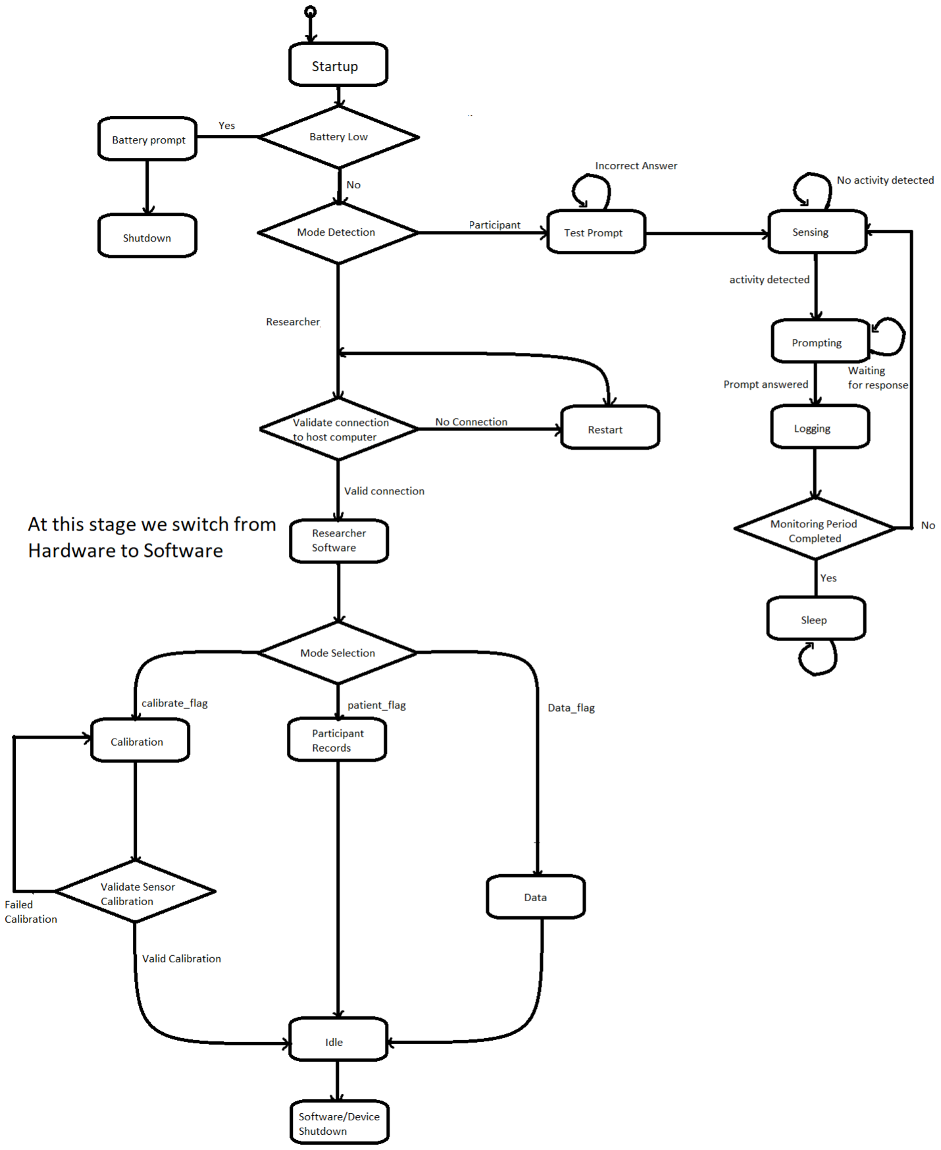
[picture p42: figure]

Figure 2: FSM

The following explains the states presented in the above Finite State Machine:

25

States:

1. Startup: Initial state of the system when it turns on. Simply transitions after checking battery life.
2. Battery Prompt: Sends a prompt to the user informing them that the device needs to be charged.
3. Shutdown: This essentially powers of the device if the battery gets too low.
4. Test Prompt: Testing the prompting system by giving a simple question to the user, Is the device on?
5. Sensing: Reads data from all the sensor and checks whether an activity is detected.
6. Prompting: Sends a prompt to the user when a registered activity is found.
7. Logging: Logs prompt answers and sensor data in the internal memory.
8. Sleep: Temporarily puts the device to sleep until it is returned to the researchers.
9. Restart: Restarts the device without going through the startup sequence.
10. Researcher Software: Initilal state of the software on the host computer. Consists of a simple welcome screen.
11. Calibration: Calibrates sensors, allows setting new thresholds and choosing what activities to track.
12. Participant Records: Allows creating and modifying participant information.
13. Data: Presents all data stored on the device in a graphcial manner.
14. Idle: Idle state of the software. Awaits any user input.
15. Software/Device shutdown: When the software shuts down, the device also turns off.

26

### 15 Legal and Regulatory Factors

All collected and analyzed non-medical data shall be protected under the Personal Information Protection and Electronic Documents Act (PIPEDA).

All medical records shall be protected under the Personal Health Information Protection Act (PHIPA).

All patients are to sign a waiver form consenting to the use of their personal information and medical records prior to using the device.

Only those with administrative rights will have access to all data files, all data to be secured with passwords.

Documentation to follow IEEE format for references and citations.

Documentation to be completed with 12pt Arial font on US Letter size paper (8.5” x 11”) with 1 inch margin on all sides.

The User Interfaces will follow guidelines outlined by the The Accessibility for Ontarians with Disabilities Act (AODA).

### 16 Phase in Plan

October 19: R2: Device has to track minor movements of user such that activity is recorded appropriately.

October 26: R3: Device has to prompt the user when the software detects no movement has occurred.

November 02: R6: The device will have to store data every time an activity takes place or a prompt is answered on the device by the user.

November 06: R7: The data stored on the device will have to be extracted such that the data is interpretable in the form of graphs and csv.

27

### References

Nora Bakaa, Douglas P. Gross, Lisa C. Carlesso, Joy MacDermid, Kenneth Thomas, Florence Slomp, Alison Rushton, Maxi Miciak, Rob Smeets, Raja Rampersaud, and et al. Presurgical rehabilitation program for patients with symptomatic lumbar spinal stenosis: A pilot randomized controlled trial protocol. Canadian Journal of Pain, 6(4), 2022. doi: 10.1080/24740527.2022. 2137009.

28

### Appendix — Reflection

The information in this section will be used to evaluate the team members on the graduate attribute of Lifelong Learning. Please answer the following questions:

1. What knowledge and skills will the team collectively need to acquire to successfully complete this capstone project? Examples of possible knowledge to acquire include domain specific knowledge from the domain of your application, or software engineering knowledge, mechatronics knowledge or computer science knowledge. Skills may be related to technology, or writing, or presentation, or team management, etc. You should look to identify at least one item for each team member.

As the team is still in the burgeoning phases of this project, it is difficult to ascertain the specific ”holes” in the team member’s specific skillsets that will need to be filled in order to complete this project successfully. However, the time the team has spent working together in the documentation phase has revealed much about what this team requires in order to succeed.

As in many multidisciplinary technical projects, diversity of skills translates to strength. In this case, that diversity stretches past knowledge in dispirate technical fields, and extends to areas such as management and business ideation.

Obviously, a mechatronics project involving designing wearable technology like this from the ground up requires skills in electronics, software engineering, mechanics, and systems design. Each of which are shared between the team members. While some team members have some experience in these fields (often through internships where team members delved deep into individual skills), there is still catching up to do in order to have the skills necessary to complete the project. After discussion, the team has decided to split these skills among themselves.

It is also essential to this project to hone non-technical skills. Without effective project management and git management, this project will fall apart. Project management in this case refers not only to the soft skills (such as effective communication, risk management, time management, etc.), it also refers to the mindset of a project manager working on an extremely time-sensitive and labour intensive project with limited resources. This mindset is often unfortunately learned through failure and hard lessons learned, but the team hopes to pre-emptively practice and hone this. Regarding git management, git is an incredibly powerful tool. However, it is an incredibly powerful tool with a steep learning curve. While this is a skill which is ideally learned by all, the team has identified a specific git leader to learn the specific nuances of git to keep the team out of trouble.

These skills-to-be-learned have been split between team members:

29

Jessica: Electronics
Oliver: Project Management Jonathan: Mechanics
Anish: Software Engineering Nish: Systems Design
Labeeb: Git Nuances
2. For each of the knowledge areas and skills identified in the previous question, what are at least two approaches to acquiring the knowledge or mastering the skill? Of the identified approaches, which will each team member pursue, and why did they make this choice?

Electronics:
(a) Review the datasheets of microprocessors and circuits previously used in classes.
(b) Attempt to build simplistic projects from online sources using electronics relevant to this project.
Project Management:
(a) Chair all meeting going forward.
(b) Interact with the stakeholders of this project in a leadership role.
Mechanics:
(a) Attempt to try on existing wearable technology and learn the limitations with current technology.
(b) Identify and analyze the material properties of common wearable technology and understand the theory behind their specific applications.
Software Engineering:
(a) Practice with linters, measuring tools for code, and additional software libraries relevant to this project.
(b) Strictly enforce coding requirements to the rest of the team.
Systems Design:
(a) Generate ”overviews” of the project, its interactions with the world around it, and the relevancy it has to society.
(b) Simplify all components of the device into a list/diagram which details the interactions each component has with each other and the inputs and outputs of the system.
Git Nuances:
(a) Be ”brave” when it comes to using git, github, git issues, and anything relevant to version control. Try weird things!
(b) Begin to implement basic CI/CD with git issues, or with an alternative service if necessary.

30
