zakerl/Capstone_Project/docs/README.md

# EMAnator documentation

The folders and files for this folder are as follows:

Design folder has details about the design aspect of the project such as Software Architecture, System Design, etc.<br />
ProblemStatementandGaols folder contains the initial setup of Goals of the project.<br />
Developoment plan folder has initial development plan and roles of different members in the team.<br />
Hazard Analysis folder is for the safety of the product along with the requirements.<br />
SRS folder has the Software requirements and functionality of the project.<br />
VnVPlan and VnVReport folders contain testing and report of the tests conducted for the device.<br />
