zakerl/Capstone_Project/EXPOPoster/Poster_BackEndDevelopers.pdf

# Back End Developers

## McMaster University Department of Computing & Software

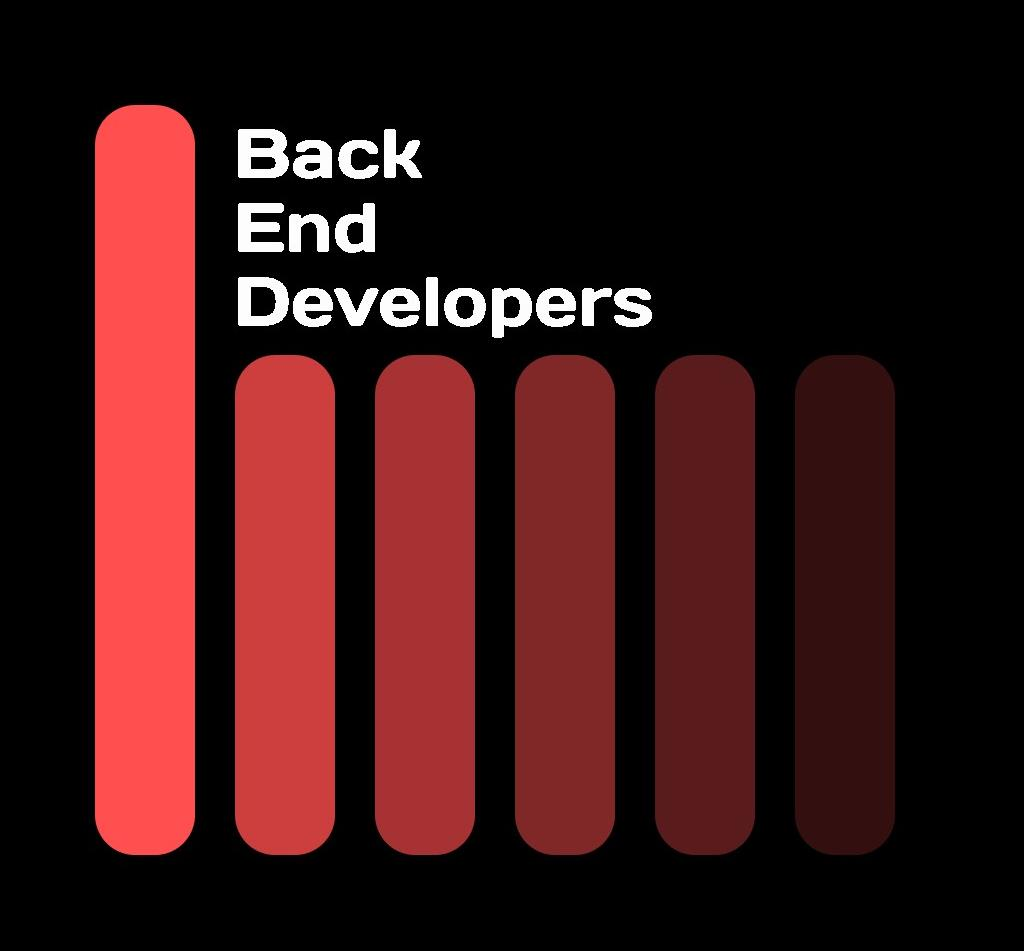
[picture p43: figure]

Motivation | Hardware Design

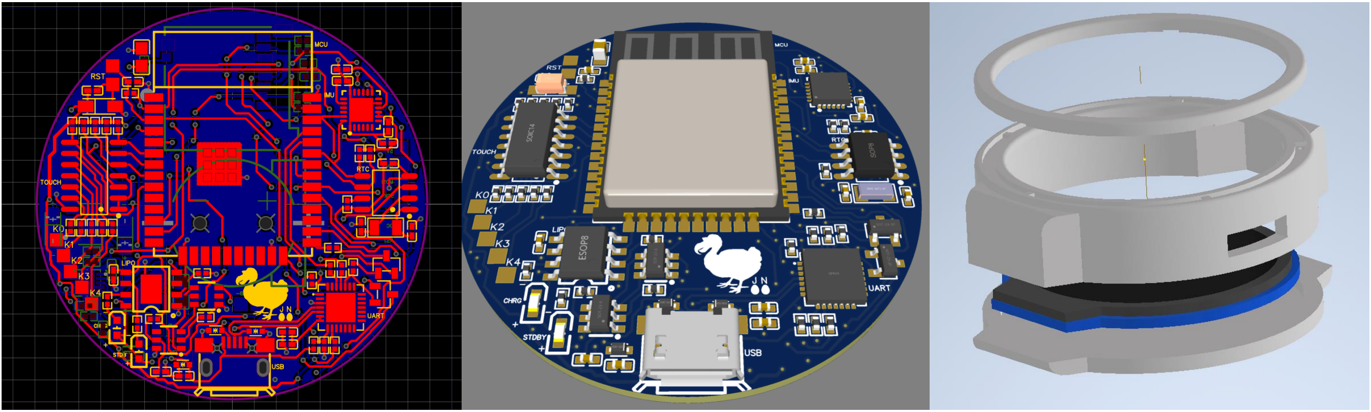
[picture p44: figure]
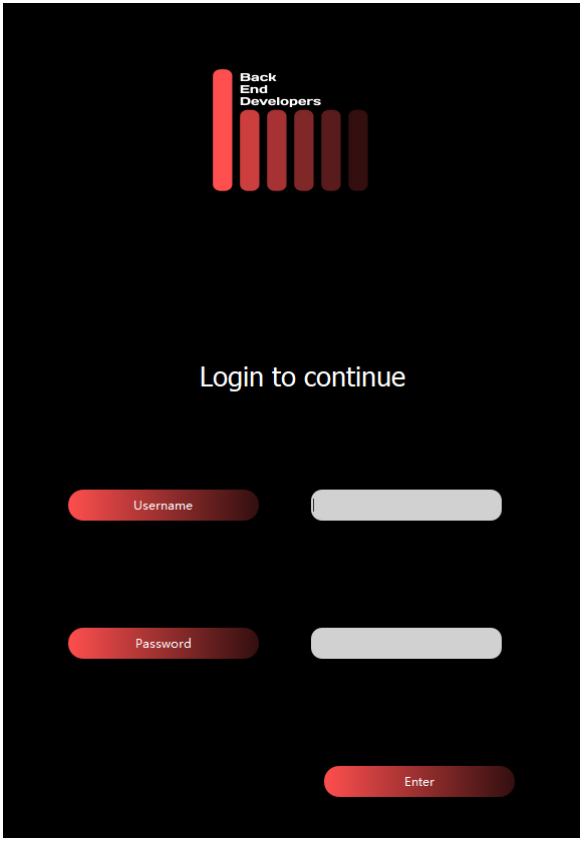
[picture p45: figure]

# Team

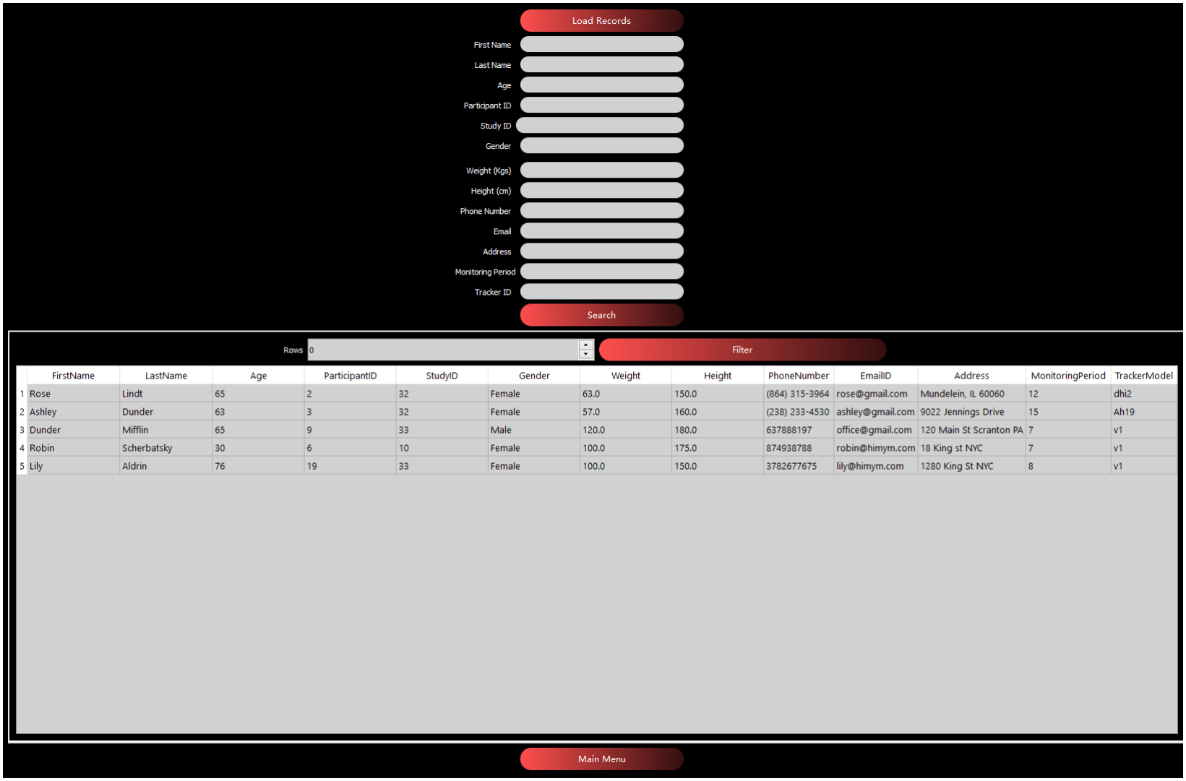
[picture p46: figure]
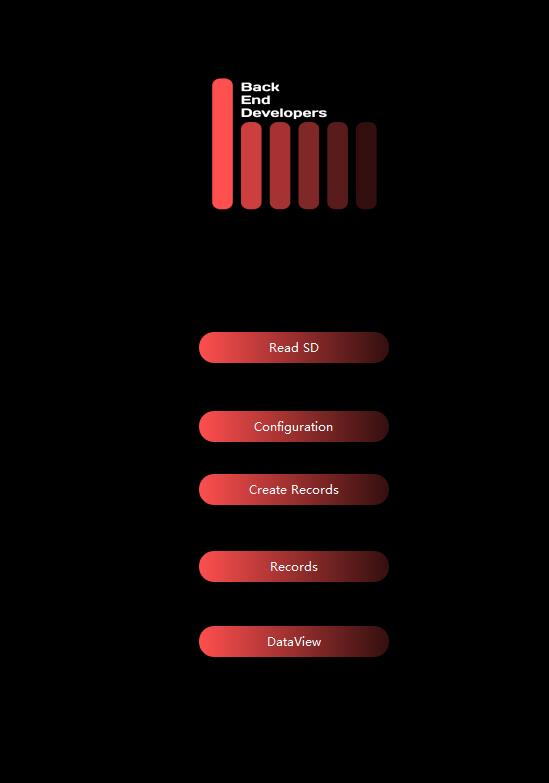
[picture p47: figure]

# Key Features

# Software Design

Anish
Rangarajan

Jonathan
Hai

Nish
Shah

Oliver
Foote

Labeeb
Zaker

Jessica
Bae

Dr. Luciana Macedo investigates treatment strategies for older adults with lumbar spinal disorders, particularly focused on Ecological Momentary Assessment (EMA).

Since the EMA work is focused on analyzing the daily activities and symptoms of mostly-older adults with mobility issues, the solution needed to capture their slow and subtle movements.

Existing commercial products are designed to capture the activities of healthy and active people, which contrasts with what needs to be captured: Shuffling, limping, slower walking, etc., and works on a time-based prompt system, only asking questions at regular intervals throughout the day.

- Touch bezels
- Bluetooth
- Activity-based prompt generation

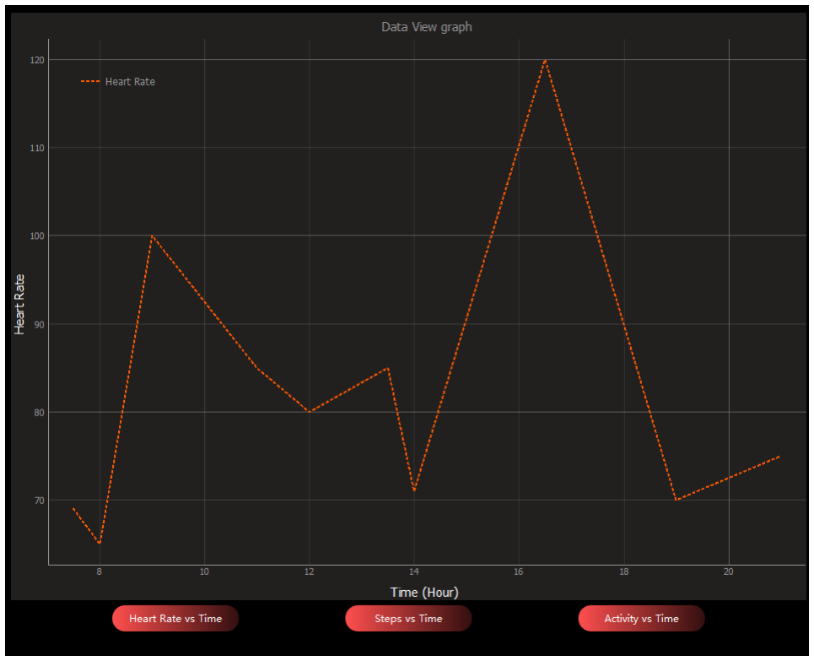
[picture p48: figure]

- Aimed for slow and subtle movements
- Research-based software UI
- Local database

### Mechatronics Engineering

Special thanks to: Dr. Macedo (School of Rehabilitation Science at McMaster University) for her time and assistance with the team throughout this project.
