zakerl/Capstone_Project/docs/Design/SystDesign/SystDes.pdf

# System Design for ProgName

### Team #, Team Name Student 1 name Student 2 name Student 3 name Student 4 name

### December 1, 2022

## 1 Revision History

Date | Version | Notes
Date 1 | 1.0 | Notes
Date 2 | 1.1 | Notes

i

## 2 Reference Material

This section records information for easy reference.

### 2.1 Abbreviations and Acronyms

symbol description

ProgName Explanation of program name [... —SS] [... —SS]

ii

## Contents

1 Revision History | i
2 Reference Material | ii
3 Introduction | 1
4 Purpose | 1
5 Scope | 1
6 Project Overview | 1
7 System Variables | 1
8 User Interfaces | 2
9 Design of Hardware | 2
10 Design of Electrical Components | 2
11 Design of Communication Protocols | 2
12 Timeline | 2
A Interface | 3
B Mechanical Hardware | 3
C Electrical Components | 3
D Communication Protocols | 3
E Reflection | 3

iii

## List of Tables

## List of Figures

iv

## 3 Introduction

[Include references to your other documentation —SS]

## 4 Purpose

[Purpose of your design documentation —SS] [Point to your other design documents —SS]

## 5 Scope

[Include a figure that show the System Context (showing the boundary between your system and the environment around it.) —SS]

## 6 Project Overview

### 6.1 Normal Behaviour

### 6.2 Undesired Event Handling

[How you will approach undesired events —SS]

### 6.3 Component Diagram

### 6.4 Connection Between Requirements and Design

[The intention of this section is to document decisions that are made “between” the requirements and the design. To satisfy some requirements, design decisions need to be made. Rather than make these decisions implicit, they are explicitly recorded here. For instance, if a program has security requirements, a specific design decision may be made to satisfy those requirements with a password. —SS]

## 7 System Variables

[Include this section for Mechatronics projects —SS]

1

### 7.1 Monitored Variables

### 7.2 Controlled Variables

### 7.3 Constants Variables

## 8 User Interfaces

[Design of user interface for software and hardware. Attach an appendix if needed. Drawings, Sketches, Figma —SS]

## 9 Design of Hardware

[Most relevant for mechatronics projects —SS] [Show what will be acquired —SS] [Show what will be built, with detail on fabrication and materials —SS] [Include appendices as appropriate, possibly with sketches, drawings, CAD, etc —SS]

## 10 Design of Electrical Components

[Most relevant for mechatronics projects —SS] [Show what will be acquired —SS] [Show what will be built, with detail on fabrication and materials —SS] [Include appendices as appropriate, possibly with sketches, drawings, circuit diagrams, etc —SS]

## 11 Design of Communication Protocols

[If appropriate —SS]

## 12 Timeline

[Schedule of tasks and who is responsible —SS]

2

## A Interface

[Include additional information related to the appearance of, and interaction with, the user interface —SS]

## B Mechanical Hardware

## C Electrical Components

## D Communication Protocols

## E Reflection

The information in this section will be used to evaluate the team members on the graduate attribute of Problem Analysis and Design. Please answer the following questions:

1. What are the limitations of your solution? Put another way, given unlimited resources, what could you do to make the project better? (LO ProbSolutions)
2. Give a brief overview of other design solutions you considered. What are the benefits and tradeoffs of those other designs compared with the chosen design? From all the potential options, why did you select documented design? (LO Explores)

3
