zakerl/Capstone_Project/docs/Design/SystDesign/BEDDisplay.jpg

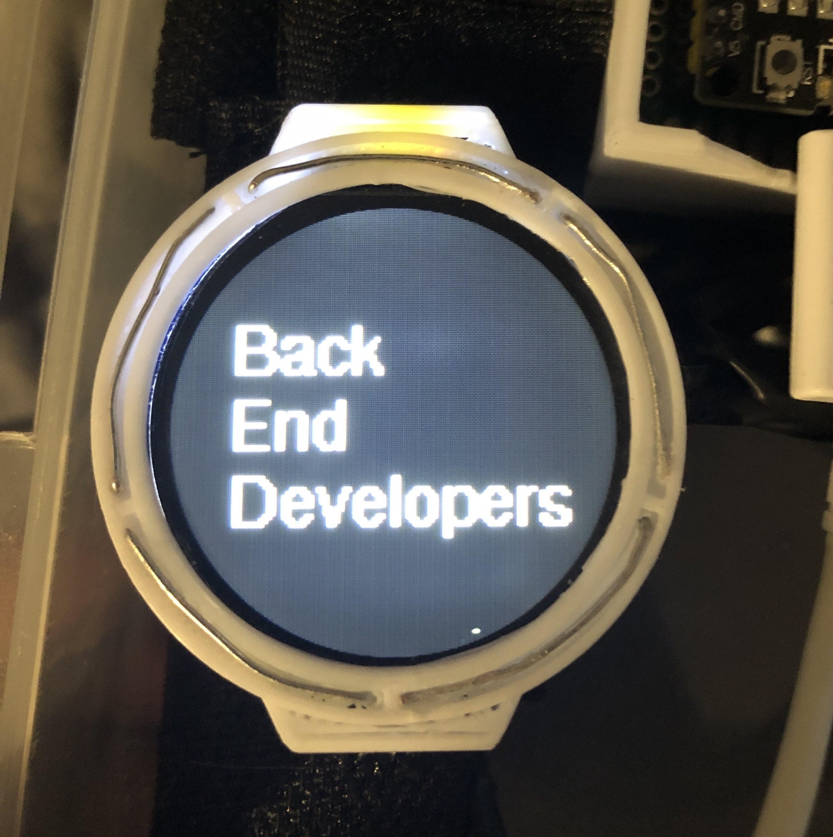
docs/Design/SystDesign/BEDDisplay.jpg
