zakerl/Capstone_Project/docs/Design/SystDesign/DisplayTime.JPG

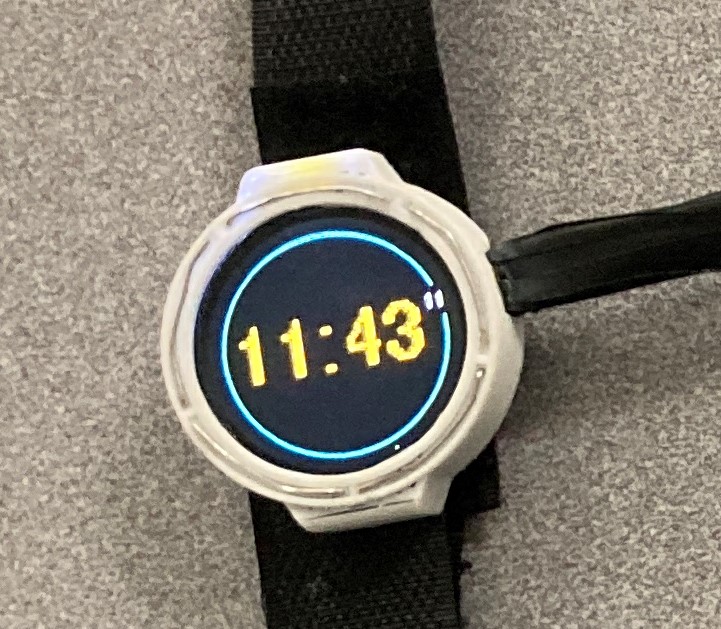
docs/Design/SystDesign/DisplayTime.JPG
