zakerl/Capstone_Project/docs/SRS/watch.png

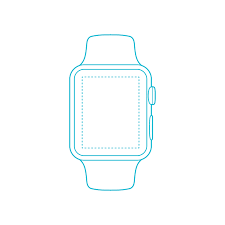
docs/SRS/watch.png
