zakerl/Capstone_Project/INSTALL.md

# EMAnator software installation
Instructions for installing EMAnator Software: 
1) Download bed_software.exe (executable on windows) and install the file on your computer.
2) Once the .exe is run, python files will be generated and the software is ready to use.
3) Run the software by creating an icon/running bed_software.exe and the UI should be generated.

Note: PyBluez may cause issues for installation. Please contact BED team to fix this.

Instructions for uninstalling EMAnator Software: 
1) Search for bed_software.exe on PC and click on uninstall.
2) Delete all dependencies of bed_software.exe by navigating to where the folder is and deleting them.
