zakerl/Capstone_Project/docs/HazardAnalysis/HazardAnalysis.pdf

# Hazard Analysis Mechatronics Engineering


### Team #1, Back End Developers Jessica Bae Oliver Foote Jonathan Hai Anish Rangarajan

### Nish Shah

### Labeeb Zaker

Table 1: Revision History
Date | Developer(s) | Change
2022-10-19 | Back End Developers | Initial documentation for Hazard Analysis
2023-03-15 | Jessica Bae | Minor improvements and proof reading for revision 1
2023-03-17 | Jessica Bae | Removed and modified requirements to align with VnV
2023-04-03 | Jonathan Hai | Incorporated TA comments
2023-04-04 | Jessica Bae | Added logo and style to the document

i

### Contents

1 Introduction | 1
1.1 Purpose of Hazard Analysis | | 1
2 Scope | 1
3 System Boundaries and Components | 2
3.1 Battery/Power Management system | | 2
3.2 Sensor Array system | | 2
3.3 Prompt generation system | | 2
3.4 Display System | | 2
3.5 Data Storage system | | 2
3.6 Device Manager | | 2
3.7 Error Handler - Hardware | | 2
3.8 Error Handler - Software | | 2
3.9 Host Software | | 2
3.10 Configuration | | 3
3.11 Records | | 3
3.12 Data View | | 3
3.13 System Boundary Diagram | | 4
4 Critical Assumptions | 5
5 Failure Mode and Effect Analysis | 5
6 Safety and Security Requirements | 14
6.1 Hardware Requirements | 14
6.2 Software Requirements | 14
6.3 Data Requirements | 14
7 Roadmap | 15

### List of Figures

1 | System Boundary Diagram | | 4

### List of Tables

1 | Revision History | | i
2 | Display FMEA
| Req: SR1, SR2 | | 5
3 | Prompt Generation FMEA
| Req: SR1, SR2, SR3 | | 6
4 | Sensor Array FMEA
| Req: HR1, SR1, SR2 | | 7
5 | Battery Management FMEA
| Req: HR2, SR1 | | 7
6 | Error Handler FMEA
| Req: SR1,SR2, DSR2 | | 8
7 | Data Storage FMEA
| Req: SR1, DSR1 | | 9
8 | Device Manager FMEA
| Req: SR1,SR2 | | 9
| ii

9 | Record System FMEA
| Req: SR1,SR2, DSR2,DSR3 | 10
10 | Data View System FMEA
| Req: SR1,SR2 | 11
11 | Host Software FMEA
| Req: SR1,SR2 | 12
12 | Configuration System FMEA
| Req: SR1,SR2,SR4 | 13
13 | Road Map | 15

iii

### 1 Introduction

The EMAnator system currently under development by the Back End Developers aims to assist researchers in performing Ecological Momentary Assessment for older adults with spinal issues. The goal of this design is to construct a system which fulfills all the requirements specified in the System Requirements Specification, (https://github.com/zakerl/Capstone_Project/blob/desDoc_Labeeb/docs/SRS/SRS.pdf) and that meets the needs of EMA researchers.

The Back End Developers hope this document serves as a useful guide for identifying the potential hazards that may be encountered in development or deployment of the design.

### 1.1 Purpose of Hazard Analysis

In today’s society, technology and engineering solutions are simply expected to work. The multitude of complex engineering designs and systems created to meet the needs of the world are expected to be infallible in the eyes of the public. When failures do occur, society considers them it shocking. When these failures happen in engineering systems critical to an aspect of safety, health, or some other critical role, people can die. In many cases, these failures are predictable and preventable in the design phase. The causes of such failures are known as hazards.

It is therefore necessary for engineers to perform extensive and thorough assessments of the systems they design in the aim to eliminate as many failures as reasonably possible. This is process is called hazard analysis.

More formally, hazard analysis is a step in the process to assess risk within an engineering system. Its aim is to identify and assess the potential conditions which may cause failure. These hazards can exist and cause failures alone, or in combination with other hazards or conditions. Once completed, a hazard analysis should provide a comprehensive assessment of the hazards within a system according to the system’s components and boundaries, the assumptions critical in performing judgments regarding hazards and the scenarios they may occur in, and the requirements necessary to ensure that these hazards will be mitigated within the realm of reasonable possibility.

### 2 Scope

The purpose of this document is to perform this hazard analysis on the system to be designed by the Back End Developers. This document will first provide a description of the system boundaries and components of the system on an abstract level (both the hardware and software components), and then will list and justify the assumptions made in order to perform this hazard analysis. These assumptions will be kept to a minimum, in the hope to reduce the number of potentially overlooked hazards. The document will then describe the Failure Mode and Effect Analysis (FMEA) done by the team of the Back End Developers, and then detail the specific safety and security requirements that have been discovered in the process of performing the hazard analysis. The document will end with a roadmap describing the steps which will be taken in order to implement the novel discovered requirements, the timeline in which they will be implemented, and what considerations must be made regarding said requirements.

### 3 System Boundaries and Components

The system consists of several components that make up the entire system.

### 3.1 Battery/Power Management system

This component facilitates stepping down/up the source voltage from the battery to the necessary values required by different parts of the device. Moreover, it consists of a charge protection circuit for battery protection (Over-voltage and Discharge). Finally present is a battery level indicator that will generate an alert should the battery life fall below a certain threshold.

### 3.2 Sensor Array system

This component represents all the various sensors that will be used to collect the state information about the user. Also consists of various filters to facilitate smooth and accurate data collection.

### 3.3 Prompt generation system

This component handles all prompt generation, from the detection of when a prompt occurs, to its specific creation and finally its display on the screen.

### 3.4 Display System

This system manages all functionality of the device’s display, such as prompt display, showing basic user feedback such as date, time, temperature, etc.

### 3.5 Data Storage system

This system handles all logging and storage of data collected by both the sensor array and the prompt generator. Data is stored along with an indication of which system it came from and all prompts will be stored with the data and time of entry.

### 3.6 Device Manager

This system handles all connection and communication between the device and the host software.

### 3.7 Error Handler - Hardware

This component constantly checks the states of every system present and ensures that if any of them fail or return an error, an alert is generated. Moreover the system will also try to fix the problem wherever possible.

### 3.8 Error Handler - Software

This component monitors the state of the host software and will attempt to solve any errors that arise and will alert the user should the attempts fail.

### 3.9 Host Software

This system is the primary interface for the researchers to analyze the data collected by the device. It consists of several features that allows the researcher to set different thresholds for activity tracking, calibrate all the sensors, update and create new records for participants, and finally interact with the data stored on the device.

### 3.10 Configuration

This system allows researchers to calibrate the sensors on the device , set and modify the different thresholds for activity tracking and create new prompts.

### 3.11 Records

This system stores all information about users present in the study. Moreover it provides functionality for researchers to create new records for new users.

### 3.12 Data View

This is where all data stored on the device can be viewed/ analyzed by the researchers in a graphical manner. The system also contains some functionality for data sorting/parsing and statistical analysis.

### 3.13 System Boundary Diagram


Figure 1: System Boundary Diagram

### 4 Critical Assumptions

- No wires will come loose during use.
- Batteries are plugged in correctly (the positive and negative ends are aligned as intended).
- All data are stored in the correct memory location.
- All subsystems work as intended.
- All off-the-shelf components work was intended.

### 5 Failure Mode and Effect Analysis

Table 2: Display FMEA | Req: SR1, SR2
Design Component | Failure Modes | Causes of Failure | Effects of Failure | Detection | Recommended Ac-tion
| Display not working | • Improper circuit connec-tion. • Battery Level too low. • Code malfunc-tion. • Physical damage to dis-play. | • Users cannot answer prompts.. • Users cannot view any infor-mation on the display. | Display system returns an error code. Display Led is OFF | • Users cannot an-swer prompts. • Users cannot view any information on the display. • Check wiring and run a diagnostic on the display sys-tem. • Replace faulty hardware.
| Incorrect information displayed. | • Display Driver faulty. • Improper inter-action between Display system and Prompt genera-tion. | Users face un-expected outputs causing improper use of device. | Display system returns an error code. | • Let Error Handler try to solve issue. • Perform a manual overview of code. • Perform a system reboot.

Display System

Table 3: Prompt Generation FMEA | Req: SR1, SR2, SR3
Design Component | Failure Modes | Causes of Failure | Effects of Failure | Detection | Recommended Ac-tion
| Prompt not generated | • Prompt genera-tion code faulty • System stuck in an idle state where no activity is detected. | • Display system will not produce an out-put. • Users will be unable to provide feedback regard-ing activity | Prompt Generation system returns an error code. | Let Error Handle try to solve the issue
| Incorrect Prompt Generated | • Prompt genera-tion code faulty • Improper inter-action between Prompt genera-tion and Sensor Array | Prompt generated produces unex-pected outputs causing improper use of device | Prompt Generation system returns an error code. Test prompt produces unex-pected outputs | • Let Error Handler try to solve issue. • Check System Ar-ray State • Perform a system reboot.

Prompt Generation System

Table 4: Sensor Array FMEA | Req: HR1, SR1, SR2
Design Component | Failure Modes | Causes of Failure | Effects of Failure | Detection | Recommended Ac-tion
| • Heart rate not detected • Skin voltage not detected • Muscle Move-ment not de-tected • No motion de-tected | • Device not worn properly • Sensor breaks down, due to passing thresh-olds limits • Device sur-face is dusty or contami-nated | EMA may not be trig-gered | Software check to see if any sensor data is being col-lected | • Ensure the device has been wrapped around properly for more accurate detection • Reboot the sys-tem • Let error handler try to solve the is-sue

Sensor Array

Table 5: Battery Management FMEA | Req: HR2, SR1
Design Component | Failure Modes | Causes of Failure | Effects of Failure | Detection | Recommended Ac-tion
| Device not starting | • Device is faulty • Battery has died • Device may have over-heated • Water may have dam-aged the battery | Device is not turned on, result-ing in no monitoring | Battery dead in-dicator appears when turn-ing on the device | • Contact the Back End Developers for maintenance.

Battery management system

Table 6: Error Handler FMEA | Req: SR1,SR2, DSR2
Design Component | Failure Modes | Causes of Failure | Effects of Failure | Detection | Recommended Ac-tion
| Security Com-promised | • Fail-open security check • Error data im-properly pro-tected • Malicious cyber at-tack | Participant data will be made vulnerable to exploita-tion | Error handler returns strange or incomplete results | Device enters data-lockdown mode, preventing data from being ac-cessed until security issue is resolved.
| Errors are strange or in-complete | • Stack overflow • Memory leak • Error previ-ously unac-counted for | Persons respon-sible for responding to errors will be unable to diagnose and ad-dress the underlying issue | Error comes in an unex-pected form, or returns no value | • Use different channels to han-dle device logic and error handling • Ensure that strange errors either return as Optional or Empty List (i.e. any value but null)

Error Handler

Table 7: Data Storage FMEA | Req: SR1, DSR1
Design Component | Failure Modes | Causes of Failure | Effects of Failure | Detection | Recommended Ac-tion
| Data stored at wrong memory location | • Incorrect software commands • Memory space doesn’t ex-ist (invalid memory selected) • Insufficient memory space • Physical damage to hardware memory chip | Lost and unsaved data | Set up er-ror handler to check if each data point is suc-cessfully stored at the correct memory location each time | Replace faulty hard-ware or set up cor-rect memory path
| Data Stored with incorrect type | • Wrong data type used for storing data | Analysis program can’t inter-pret data | Failed data analysis | Convert data to cor-rect type

Data Storage

Table 8: Device Manager FMEA | Req: SR1,SR2
Design Component | Failure Modes | Causes of Failure | Effects of Failure | Detection | Recommended Ac-tion
| Unable to es-tablish connec-tion | • Loose wires • Incorrect commu-nication protocol • Incorrect parameters for serial packets (size, for-mat, etc.) | • Data can’t be trans-ferred between hard-ware and software • Lost data | • Check list of con-nected devices on de-vice manager • Visual in-spection of wiring and cir-cuitry • Attach an error detection LED on the de-vice | • Make sure all necessary con-nections are made • Reboot device • Restart host soft-ware

Device manager

Table 9: Record System FMEA | Req: SR1,SR2, DSR2,DSR3
Design Component | Failure Modes | Causes of Failure | Effects of Failure | Detection | Recommended Ac-tion
| Records not cre-ated and deletion of records | • Code that writes to database is faulty. • Connections between software systems are in-correct. | • Present users lose data, new users cannot have data stored. • Time loss. | • Records system returns an error code us-ing error check-ing. • Database trigger for stag-nant data. | Create redundant data sets and stor-age units, or cloud storage of data.

Records

Corrupted
records
- Code is
faulty.
•
Database
structure
is faulty.
- Wrong
datatype
used for
storing
data.

Data
stored for
various
users is
unusable.
- Detect
if data
records
are returning
unusable
values,
e.g.
NaN,
Inf, 0,
garbage
values.
- View
values
stored in
database
to check
for unexpected
outputs.
- Prevent | users
from | accessing
database.
- Ensure database
is | robust | prior
to | deployment
through testing.

Table 10: Data View System FMEA | Req: SR1,SR2
Design Component | Failure Modes | Causes of Failure | Effects of Failure | Detection | Recommended Ac-tion
| Data not visible | • Data col-lection failure. • Poorly aggre-gated data. • Incorrect software imple-menta-tion. • Statistical analysis of data is faulty. | Information provided is not useful to re-searchers or partici-pants. | • Error handling to detect if the software is not perform-ing as it should be. • Check error codes of device man-ager. | • Visual inspection to make sure de-vice is working. • Ensure database is robust prior to deployment through testing
| Graphical data repre-sentation incorrect. | • Improper commu-nication with device man-ager. • Device malfunc-tion, no correct data. | Incorrect observa-tions could be made based on the data. | • Error handling to detect if the software is not perform-ing as it should be. • Check error codes of device manager | • Visual inspection to make sure de-vice is working. • Use error handler to solve issue.

Data View

Table 11: Host Software FMEA | Req: SR1,SR2
Design Com-po-nent | Failure Modes | Causes of Failure | Effects of Failure | Detection | Recommended Action
| Calculation and float-ing point error | • Improper units used (metric vs Impe-rial) • Rounding error • Floating point con-version error | • Wrong informa-tion can be re-ported. • Rounding errors can propagate through differ-ent formulae resulting in data inaccuracies. • Data calculated will be com-pletely wrong due to binary overflow. | • Unit and inte-gration testing for checking proper metrics and calculation. • Boundary con-dition testing for detecting binary over-flow/floating point conver-sion errors. | • Avoid/fix type conversion and export raw data collected through hard-ware in case calculation of other metrics for tracker fails. • Use error han-dler to solve is-sue.
| Memory allocation failed | • Memory fragmen-tation or overflow due to Dynamic memory alloca-tion. | • This can cause data to be over-written and also failure of storing data. | • Host software stops running and system fails. | • Reboot Soft-ware and make sure to free memory if not using it during memory alloca-tion.
| Security threats and data loss | • Malware injected. • SQL injection. | • Software could have catas-trophic failure and device could stop run-ning. • SQLi cyber-attack can let attackers view or modify the database caus-ing data leaks. | Unrecognizable patterns and pro-cesses running in the host software. | • Run a closed-loop network to avoid backend database ma-nipulation. • Limit access of tracker to Inter-net/IoT devices to avoid hacking and data leak-age. • Perform a man-ual overview of system and processing run-ning.

Host Software

Table 12: Configuration System FMEA | Req: SR1,SR2,SR4
Design Com-po-nent | Failure Modes | Causes of Fail-ure | Effects of Failure | Detection | Recommended Action
| Threshold adjustment fails | • Threshold settings changed by Researcher not registered correctly. • Code fails to save and keep settings for threshold. | • Wrong configu-ration of device can lead to false measurements and data re-ported. | • Boundary condition check to see if threshold values en-tered are reason-able. • System-wide check for check-ing last modified date of configu-ration of device. | Report error if threshold values are incorrect and Reboot system.
| Calibration fails | • System stuck in idle state and does not record refer-ence for cali-bration. • Not enough power for sen-sors/system to calibrate. • Code to cali-brate sensors and system fails. | • Wrong Calibra-tion of system will result in incorrect activity detection. • Data will be false/will not be measured correctly. | Display message to check if all calibration is completed correctly. | Reboot sys-tem and check wiring to sen-sors. Let error handler solve issue.

Configuration of device

### 6 Safety and Security Requirements

### 6.1 Hardware Requirements

1. HR1: Device components will have sufficient electrical tolerances for various voltage levels.
2. HR2: Charge protection circuity will be integrated to avoid overcharging of the battery.

### 6.2 Software Requirements

1. SR1: The Error Handler will initially try to solve all Non-Hardware issues.
2. SR2: Tests will be conducted for all Software before deployment to the device.
3. SR3: All users are required to complete the test prompt.
4. SR4: Configuration setting will fall within accepted boundaries.

### 6.3 Data Requirements

1. DSR1: All data to be backed up, in case of power failure.
2. DSR2: Access to records will be restricted to administrative users with encrypted ssh access key.
3. DSR3: The device will not modify user data unnecessarily.

### 7 Roadmap

Table 13: Road Map
When to Implement | Requirement | Priority
During Course | HR1 | High
| HR2 | Very High
| SR1 | Low
| SR2 | High
| SR4 | High
| DSR1 | Very High
| DSR3 | Very High
Postponed* | SR2** | High
| SR3 | Low
| DSR2 | Very High

*Requirement implementation postponed past course completion.
**Regarding software imported to device after course completion.

Postponed requirements are not of lower priority than the requirements to be completed during the course. However, these postponed requirements can only come into effect once the device begins operation in its intended use cases. Otherwise, they are meaningless during the development phase. In addition, low priority values do not mean that the requirement may be dropped. Instead, it means that the implementation of said requirement may be easier, or less critical to the safety of the device, safety of the user, or functionality in general.

### Appendix

### Therac-25 case study

The Back End Developers would like to take a section of this document to describe the importance of hazard analyses (and other relevant documentation). A perfect example of this is the Therac-25.

The Therac-25 was a radiotherapy machine designed by Atomic Energy Canada Limited (AECL) in 1982. It was designed to treat cancer by sending beams of high-energy particles (either electrons or x-rays) through a patient’s tumor, thereby killing it. This machine was one of the first of its kind to be computer controlled; using software to direct its functions rather than interdependent physical mechanisms. [Leveson(1999)] Considered state-of-the-art at the time, the Therac-25 promised to revolutionize radiotherapy.

However, there were problems. Operators of the machine would find that they encountered many error messages from the computer console, of which none were explained by AECL. These errors were non-descript, and often simple read ’MALFUNCTION’ followed by a number. The same operators stated that they had grown used to these messages, and often ignored them and proceeded with treatments. Also, none really knew how the Therac-25 was programmed. The original developer had developed the software for the previous Therac-6 and Therac-20 models of radiotherapy machines, and had since left the company. AECL had directly ported the software into the Therac-25, and did not test the combination of the software and the new hardware properly.

Cancer patients treated using the Therac-25 began to report issues. They entered the machine thinking that the procedures would be painless (which is usually true for radiotherapy). However, they often felt powerful shocks and intense burning sensations around the areas that the Therac-25 would administer radiation. Later on, these same patients would fall heavily sick with symptoms identical to those with acute radiation poisoning. Some patients had to have entire limbs removed due to intense radiation damage, and none knew why. The AECL assured the operators that the machine was incapable of administering deadly doses of radiation, and attested to its safety.[Leveson and Turner(1993)] In reality, the machine was exposing patients to doses of radiation hundreds of times greater than what was prescribed.[Baase and Henry(2019)] Between 1985 and 1987, three people died of radiation exposure due to the Therac-25, and two others sustained lifelong injuries.

A later investigation revealed that when operators changed from the electron mode of the machine to the x-ray mode in a certain way, the Therac-25 would fail to move a dampening shield between the fully powered x-ray and the patient. This dampening shield served to lower intensity of the x-ray beam to safe levels. The software would correctly detect an error, but simply displayed a window with the text ’MALFUNCTION 54’. Having grown used to these messages, the operators would proceed with treatment without the shield in place. In addition, a flag variable which would instruct the machine to perform safety checks was designed to be set by incrementation rather than being set to a fixed value. This flag would often overflow from its maximum value of 255 to zero, which instructed the machine to bypass safety checks. A later review would reveal that the Therac-25 had eleven separate critical engineering and institutional failures which would have put a patient’s life in danger. The combination of these factors caused the Therac-25 to give unlucky patients massive radiation overdoses. In response to this incident, the International Electrotechnical Commission (IEC) released standard IEC 62304; a standard which details development lifecycle standards specifically for software present on medical devices. It also describes the dangers and guidance regarding Software of Unknown Pedigree (SOUP).

The worst part is that none of this had to happen. Should a hazard analysis have been performed, the team at AECL who designed the Therac-25 would have known that unaccounted arithmetic overflows could bypass safety features. They would have known that the software written by the original Therac-6 and Therac-20 developer could not be maintained and troubleshot even for the most basic errors. They would have known that non-descript errors in a system like the Therac-25 could potentially be life-threatening.

They would never have assured machine operators that overdoses were impossible. Had they done so, they would have never decided that a direct port of the Therac-20 software would have been appropriate for the system they were designing. They may have thrown out the software all together and started from scratch. This would have taken much more time and many more resources than a simple port, but that team had a responsibility to ensure that the potential hazards of the Therac-25 were accounted for and mitigated. It would have been a good decision. As they did not make it, three patients died from treatments meant to save their lives.[Rose(1994)]

Events like these are a sobering reminder of the responsibilities that engineers have to the products they design, the users of said products, and to the world that their systems exist in. A hazard analysis is an essential document to ensure that catastrophic failures do not occur as a result of an engineer’s work. It can act as a reminder to engineers that there is a reason to all of this procedure, and that documentation is essential because the risks are real. It is the responsibility of every engineer to ensure cases such as the Therac-25 never happen again.

### Error Codes

To facilitate error handling, every system will return an error code that represents the status of that system. These error codes follow the following format, BED ERR ERRORTYPE For example BED ERR NONE represent that the system is working correctly. Some more examples of error codes are:

- BED ERR PARAM ERR : Represents an error with the parameters of the function.
- BED ERR GENERAL : Represents a generic error that has not been cataloged yet.
- BED ERR INVALID DATA SIZE : Represents an error related to a size mismatch in what is stored within a block of memory or variable.

### References

[Baase and Henry(2019)] Sara Baase and Timothy Henry. A gift of fire: Social, legal, and ethical issues for Computing Technology. Pearson, 2019.

[Leveson(1999)] Nancy G. Leveson. Appendix A: Medical Devices: The Therac-25. Addison-Wesley, 1999.

[Leveson and Turner(1993)] N.G. Leveson and C.S. Turner. An investigation of the therac-25 accidents. Computer, 26(7):18–41, Nov 1993. doi: 10.1109/mc.1993.274940.

[Rose(1994)] Barbara Wade Rose. Fatal dose, Jun 1994. URL http://www.ccnr.org/fatal dose.html. (http://www.ccnr.org/fatal_dose.html)
