zakerl/Capstone_Project/(threads)

Thread 22 (2022-10-10):

Review-SRS-Team30: Add external link to EMA

edwin-do, 2022-10-10:
- Add an external link to EMA related information for users to reference and learn more about EMA in section 1 under reference material

P.S No permission to add label to issues

edwin-do, 2022-10-10:
@CSchank

Closed 2023-04-06.

Thread 23 (2022-10-10):

Review-SRS-Team30: Conflicting open issue and assumption

edwin-do, 2022-10-10:
- Open issue states to decide on a data transfer protocol such as wifi, bluetooth or ethernet
- Assumption states that no wireless data transfer will occur for data privacy
- Might be a good idea to clarify this in the document

P.S No permission to add label to issues

edwin-do, 2022-10-10:
@CSchank

Closed 2023-04-06.

Thread 26 (2022-10-10):

Review-SRS-Team30: Functional Requirement (R7)

chent61, 2022-10-10:
The functional requirement can be broken down into two different requirements:

- Requirement stating that the data will be extracted from the device
- Requirement stating that the data will be in the form of graphical representation

When broken up into smaller parts, it allows both parts to be worked on by separate developers or allows for the completion of one requirement before continuing on with the next.

P.S No permission to add label to issues

chent61, 2022-10-10:
@CSchank

Closed 2023-04-06.

Thread 39 (2022-10-20):

Team29 Review: Data Storage Requirement Consideration

Kabishan, 2022-10-20:
@CSchank

First of all, an excellent effort on the Hazard Analysis document :)

If the data values or records cannot be retrieved because the database has been damaged, one could  replace the chip and in anticipating this failure, have a copy of these files on the cloud, but what happens when the connection to the external database has also failed. In that case, please consider whether or not the information would be lost irretrievably and what to display to the users of the system in this situation.

Closed 2023-04-06.

Thread 41 (2022-10-23):

Review-HA-Team29: Physical security

davidwyao, 2022-10-23:
@CSchank

Very comprehensive analysis with illuminating case study at the end.

One thing I was curious about was your plan for resistance to physical tampering and accidental inputs from participants, or others with access to the device. Your security measures seem to focus on malicious attack and data vulnerability, so I think you should consider things like junk inputs as well. Maybe some kind of error flag or an expansion of your lockdown mode would help accomplish this.

Closed 2023-04-06.

Thread 43 (2022-10-23):

Review-HA-Team29: Battery Failure

albertzevanescent, 2022-10-23:
@CSchank

For the battery management FMEA, you have possible causes of failure as the battery having no power/not being able to provide power. Yet, the detection is from an indicator turning on. Is this indicator not powered by the same battery? Instead, you could have another indicator representing when the system is powered on and it's powered off when there's an issue, like with the display led.

Closed 2023-04-06.

Thread 52 (2022-11-06):

Review-HA-Team28: Date Beyond Capabilities

JasonSurendran, 2022-11-06:
Very throughout report, solid job!
For the DT 4: Date Beyond Capabilities section, it says that a date greater than what the battery life of the device can support should throw an error. I believe it would be important to state what that specific value would actually be (using either your best guess or some basic calculation). It could help you better understand the exact limitations of your device, and how far out beyond the current date your device will still be applicable.

Closed 2023-04-06.

Thread 56 (2022-11-09):

Review-VnV-Team28: SRS Verification Plan

Dharakverma, 2022-11-09:
Wow, this is a great write-up. Excellent work all.

Please correct me if I am wrong, but is the power supplied to the device, not a functional requirement? I noticed you have multiple voltage source-related non-functional requirement tests listed, and the ones related to overvolt or undervolt I could understand being non-functional, but HST_2 is a normal voltage test, which from my understanding affects the functionality and operations of your device.

Closed 2023-04-06.

Thread 77 (2023-01-22):

Team27 Review: Design Docs

GilbertCherrie, 2023-01-22:
Overall really well done but I did notice some minor formatting issues such as the comment that should be removed from Section 5 of the SystDes.pdf:

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

also the references section of the MG.pdf should be on its own page just to keep consistent formatting with your other documents:

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

Closed 2023-04-06.

Thread 79 (2023-01-23):

Team27 Review: Design Docs

aggarwal-h, 2023-01-23:
Overall, the documentation is done well. Some issues I found were that a few modules are missing **Access Routine Semantics**. For example: MIS of Battery Management Module contains an **Exported Access Program** called `Bat_State`, but this is not included in the **Access Routine Semantics** section.

Closed 2023-04-06.
