zakerl/Capstone_Project/UI/python_scripts/handler/Config.txt

Number of Activities:232
Prompts Generated:22
Threshold for velocity measurement:12
Threshold for Steps in a day:56
Sensitivity of movement detected:44
Study ID:1
