zakerl/Capstone_Project/(commit log)

2022-09-24 Got started on Development plan. Not done with it but still wanna commit to keep track yeee
2022-09-27 Added battery life as a constraint
2022-09-27 Battery Life Update Pt. 2: Updated base goals section to 7-14 day battery life
2022-10-01 Initial documentation for accelerometer math
2022-10-04 some traceability stuff and required behavior stuff
2022-10-05 Moved in NFR's R's and Asumpts, Created Traceability
2022-11-01 Added NFR test cases and traceability matrix template
2022-11-10 Added back to mainmenu buttons and sample config/dataview
2022-11-16 loaded data into GUI
    [Records.csv]
2022-11-19 Updated Records window
    [Records.csv]
2022-11-20 Finished Records window
    [Records.csv]
2022-11-20 Added DataView window
    [DailyData.csv]
2022-11-20 Added back menu buttons
    [Records.csv]
2022-11-21 Graph done for dataview
    [DailyData.csv]
2022-11-21 Designed the config window
    [Config.txt]
2022-11-22 Fixed button sizing bug
    [Config.txt]
2022-12-07 Made python packages, cleaned up UI directory
    [Config.txt, DailyData.csv, Records.csv]
2022-12-13 DB setup
    [DailyData.csv, Records.csv]
2023-01-18 Added battery management module
2023-02-03 Records db done
    [Config.txt, DailyData.csv, Records.csv]
2023-02-05 added microSD arduino code
2023-02-05 Changes to dataview filtering
2023-02-05 Dataview filtering works properly
2023-02-06 Added sd button
2023-02-06 Added records button sizing
2023-03-04 Added in list of rejected/accepted HR sensors
2023-03-04 merged Jessica and Labeeb parts: added in initial traceability matrices
2023-03-05 Finished traceability matrices
2023-03-05 Added battery levels image
2023-03-20 Bluetooth works well not buggy anymore
    [esp_serial_BT.ino]
2023-03-21 Commit for pybluez
    [Config.txt]
2023-04-04 Updated folder names
    [Config.txt]
2023-04-04 added reference to existing material for EMA
